USb-dB/5ns-Spike-Based-RRAM-Memory-Controller-/Documentnts_Reports/Presentation.pdf

# DE0-NANO

## The DE0-Nano board is a compact and versatile FPGA development platform designed by

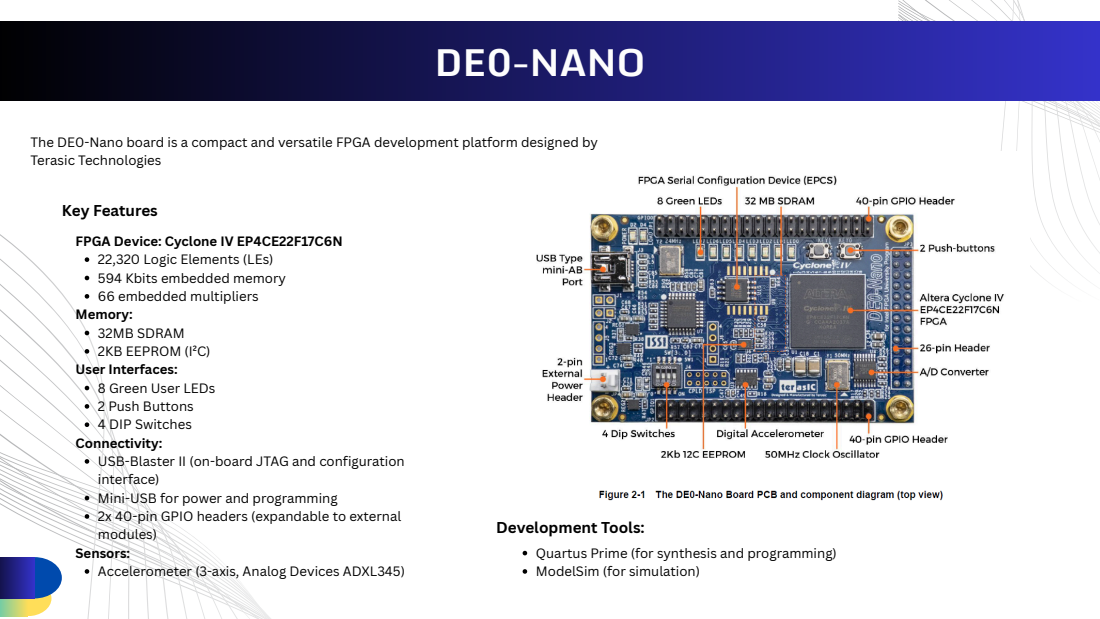
[picture p32: page 1]
Terasic Technologies; Key Features

FPGA Device: Cyclone IV EP4CE22F17C6N
22,320 Logic Elements (LEs)
594 Kbits embedded memory
66 embedded multipliers
Memory:
32MB SDRAM
2KB EEPROM (I²C)
User Interfaces:
8 Green User LEDs
2 Push Buttons
4 DIP Switches
Connectivity:
USB-Blaster II (on-board JTAG and configuration
interface)
Mini-USB for power and programming
2x 40-pin GPIO headers (expandable to external
modules)
Sensors:
Accelerometer (3-axis, Analog Devices ADXL345)

Development Tools:
Quartus Prime (for synthesis and programming)
ModelSim (for simulation)

# IN-BUILT CLOCK AND ADC

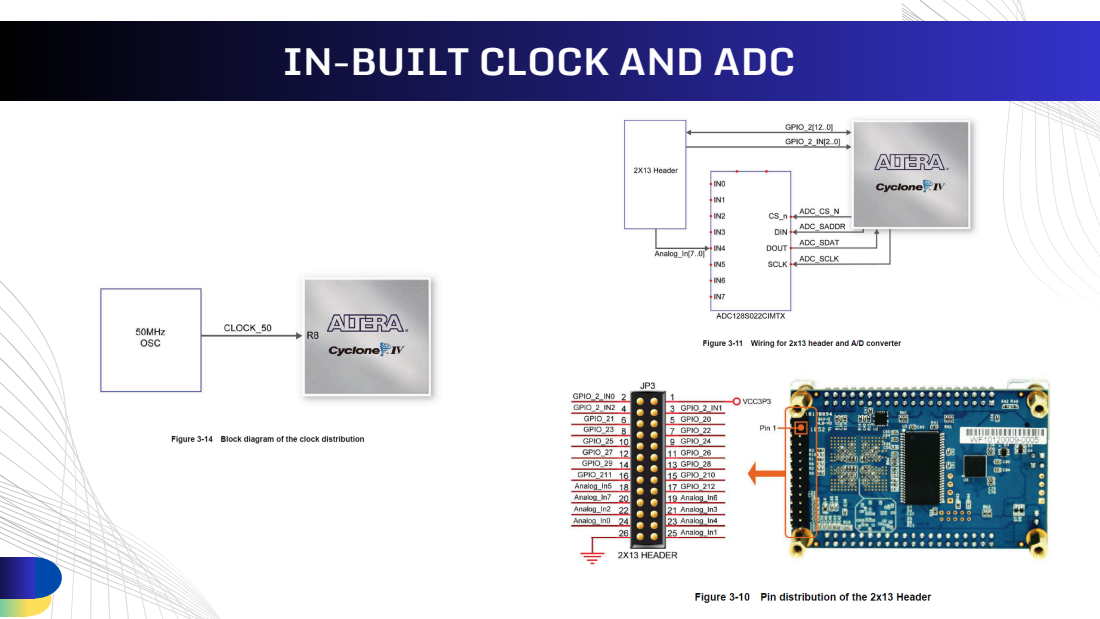
[picture p33: page 2]

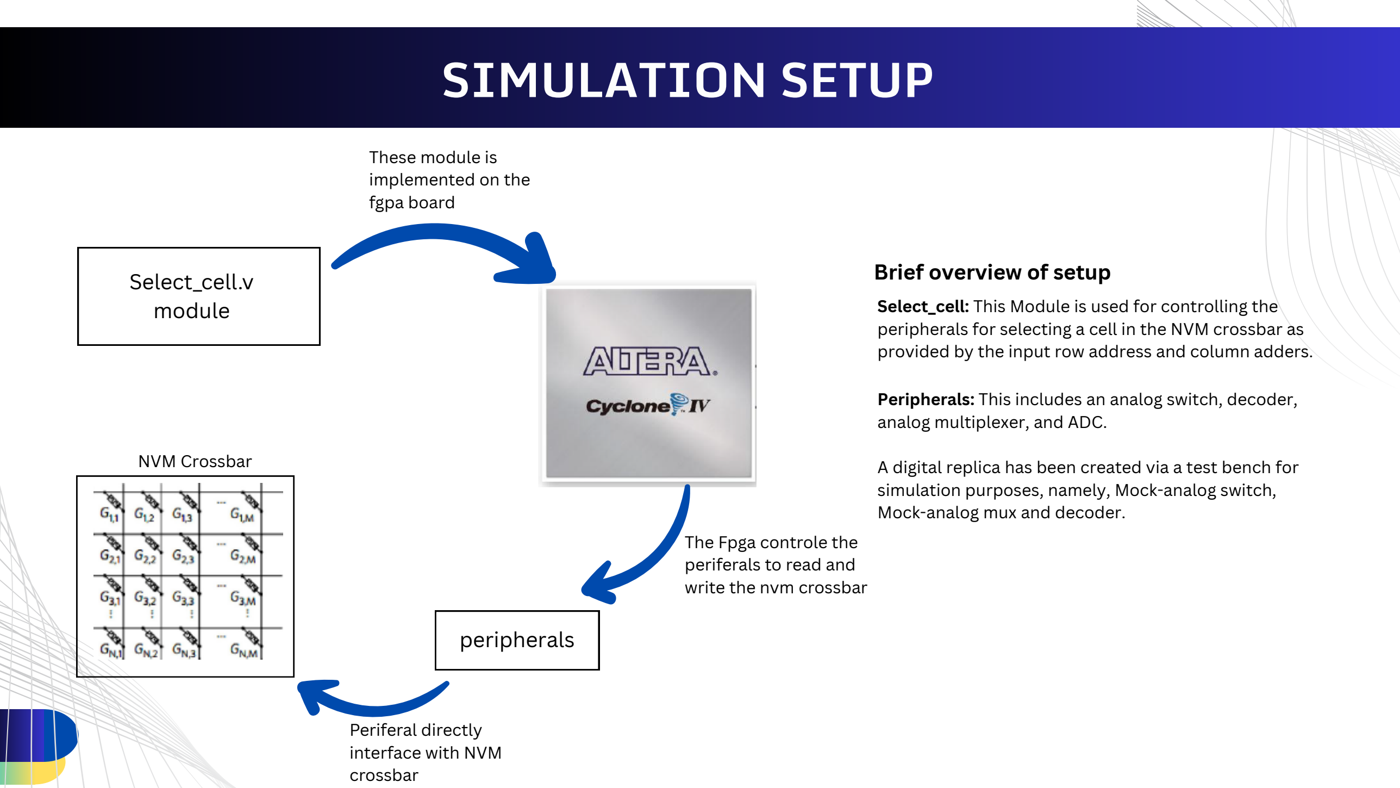
[picture p34: figure]
peripherals; SIMULATION SETUP; Select_cell.v module; These module is implemented on the fgpa board; The Fpga controle the periferals to read and write the nvm crossbar; Periferal directly interface with NVM crossbar; NVM Crossbar; analog multiplexer, and ADC.; Mock-analog mux and decoder.; Brief overview of setup

## Select_cell: This Module is used for controlling the peripherals for selecting a cell in the NVM crossbar as

provided by the input row address and column adders.

Peripherals: This includes an analog switch, decoder,

## A digital replica has been created via a test bench for

simulation purposes, namely, Mock-analog switch,

# SIMULATION SETUP

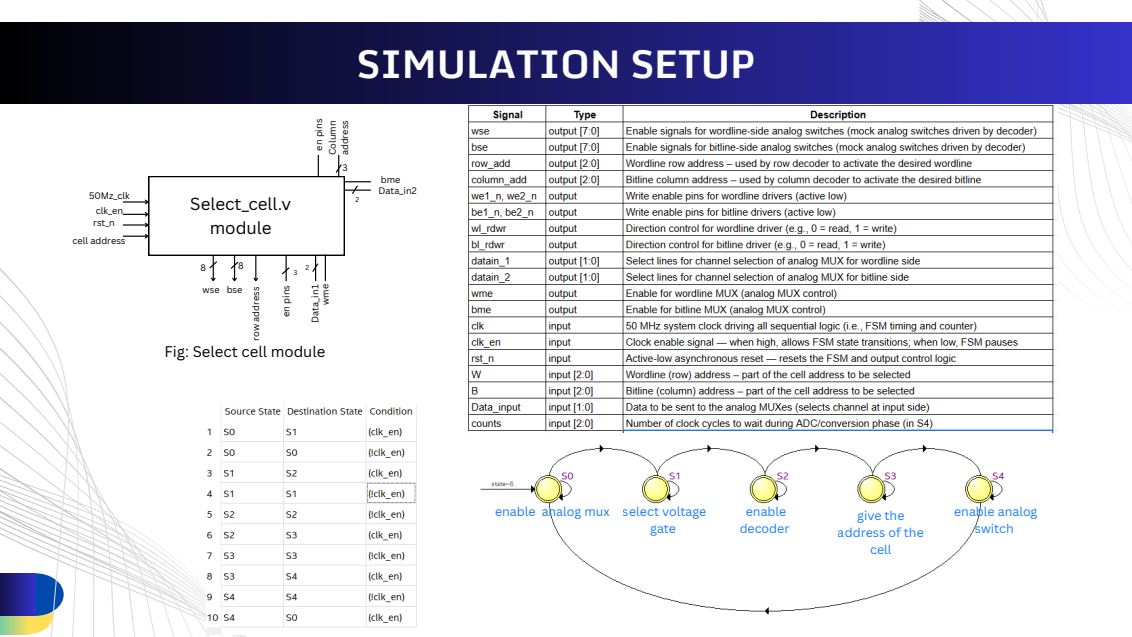
[picture p35: page 4]
pin; Select_cell.v module; 50Mz_clk clk_en rst_n; cell address; bme Data_in2; olu; dre; ata; wse bse; gate; enable decoder; enable analog switch

Fig: Select cell module

enable analog mux select voltage

give the
address of the
cell

# SIMULATION SETUP

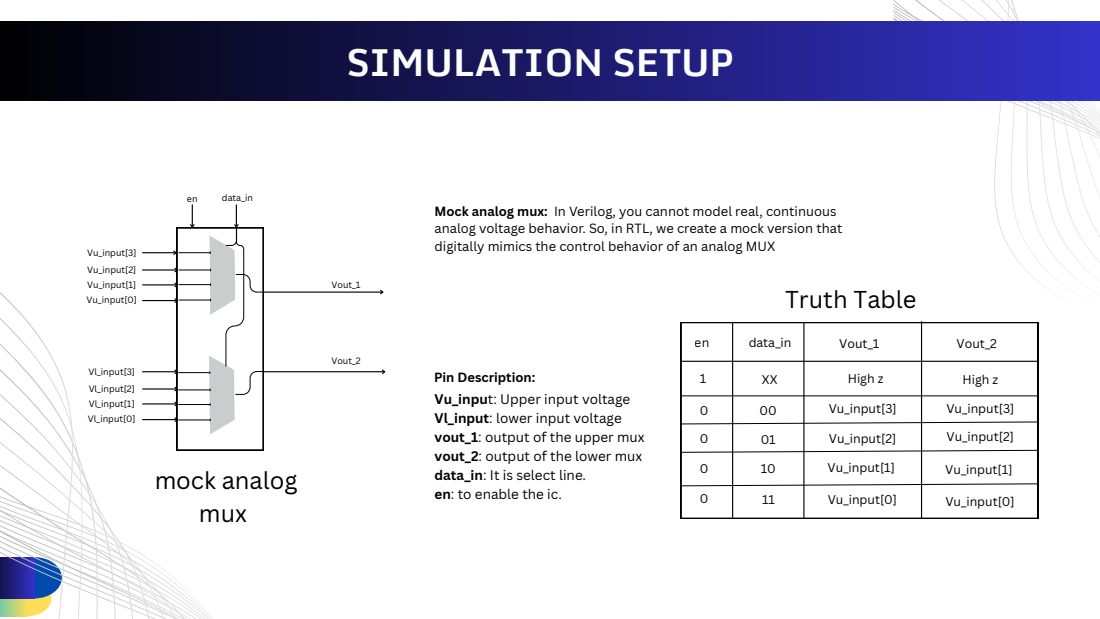
[picture p36: page 5]
mock analog mux; Vout_1; Vout_2; data_in; Vu_input[3]; Vu_input[2] Vu_input[1] Vu_input[0]; Vl_input[3]; Vl_input[2] Vl_input[1] Vl_input[0]; Vu_input[2]; Vu_input[1]; Vu_input[0]; Truth Table; High z

Mock analog mux: In Verilog, you cannot model real, continuous
analog voltage behavior. So, in RTL, we create a mock version that
digitally mimics the control behavior of an analog MUX

Pin Description:
Vu_input: Upper input voltage
Vl_input: lower input voltage
vout_1: output of the upper mux
vout_2: output of the lower mux
data_in: It is select line.
en: to enable the ic.

# SIMULATION SETUP

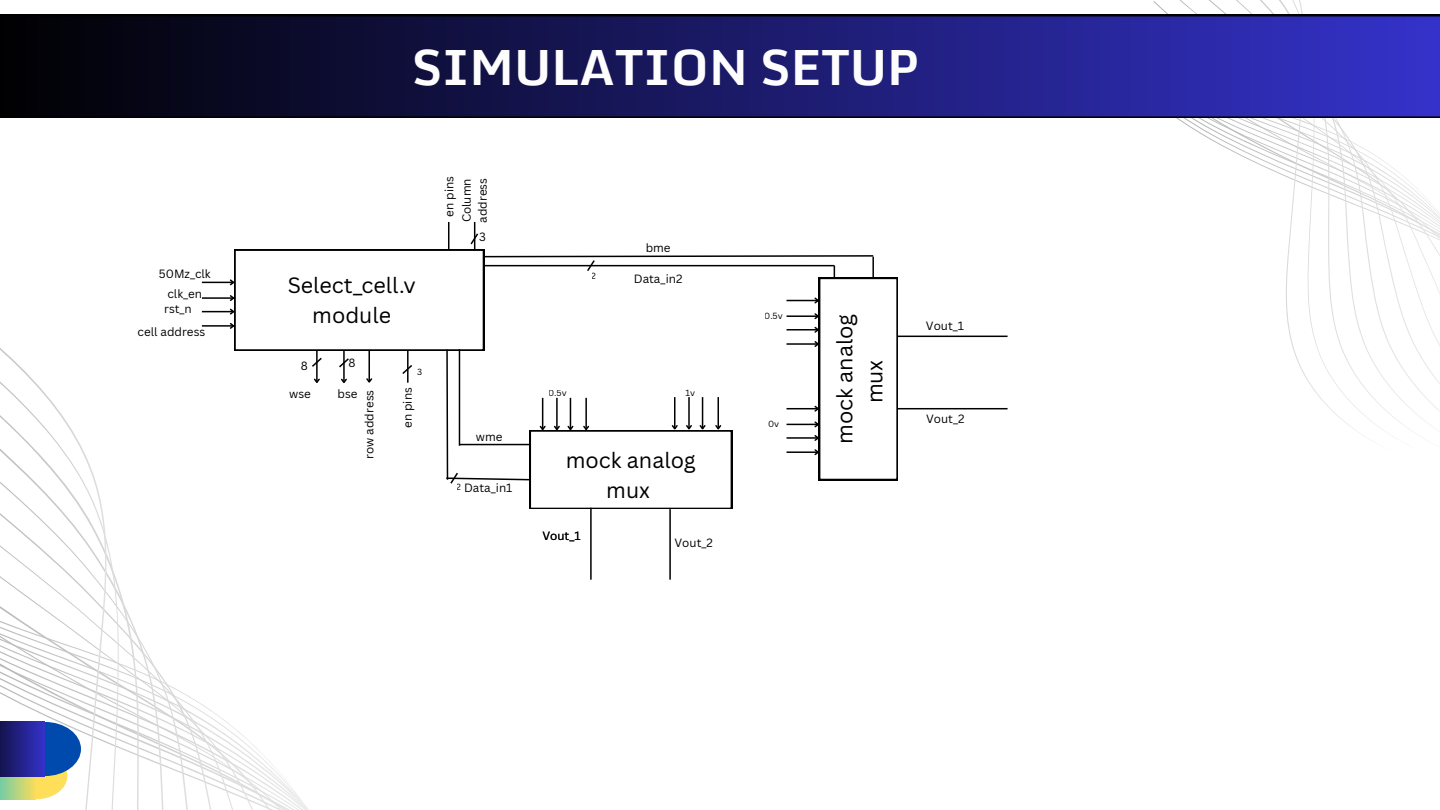
[picture p37: page 6]
Select_cell.v module; mock analog mux; alo; bme; Data_in2; Vout_1; 50Mz_clk clk_en rst_n; cell address; wse; bse; wme; Data_in1; pin; olu; dre; Vout_2

# SIMULATION SETUP

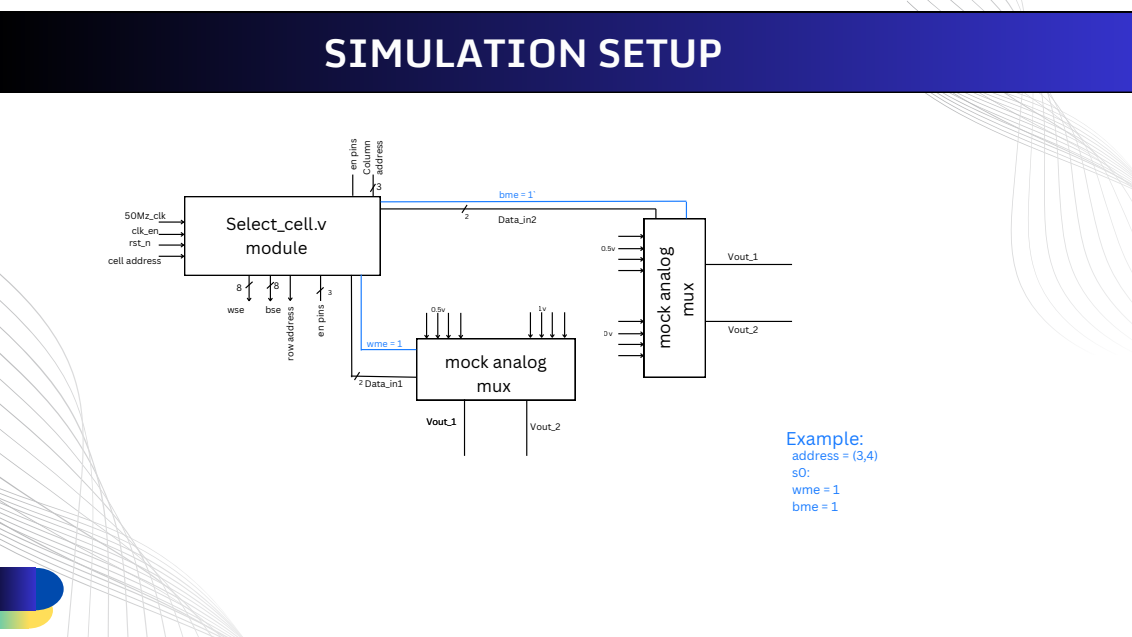
[picture p38: page 7]
Select_cell.v module; mock analog mux; alo; bme = 1`; Data_in2; Vout_1; 50Mz_clk clk_en rst_n; cell address; wse; bse; wme = 1; Data_in1; pin; olu; dre; Vout_2; Example: address = (3,4) s0: wme = 1 bme = 1

# SIMULATION SETUP

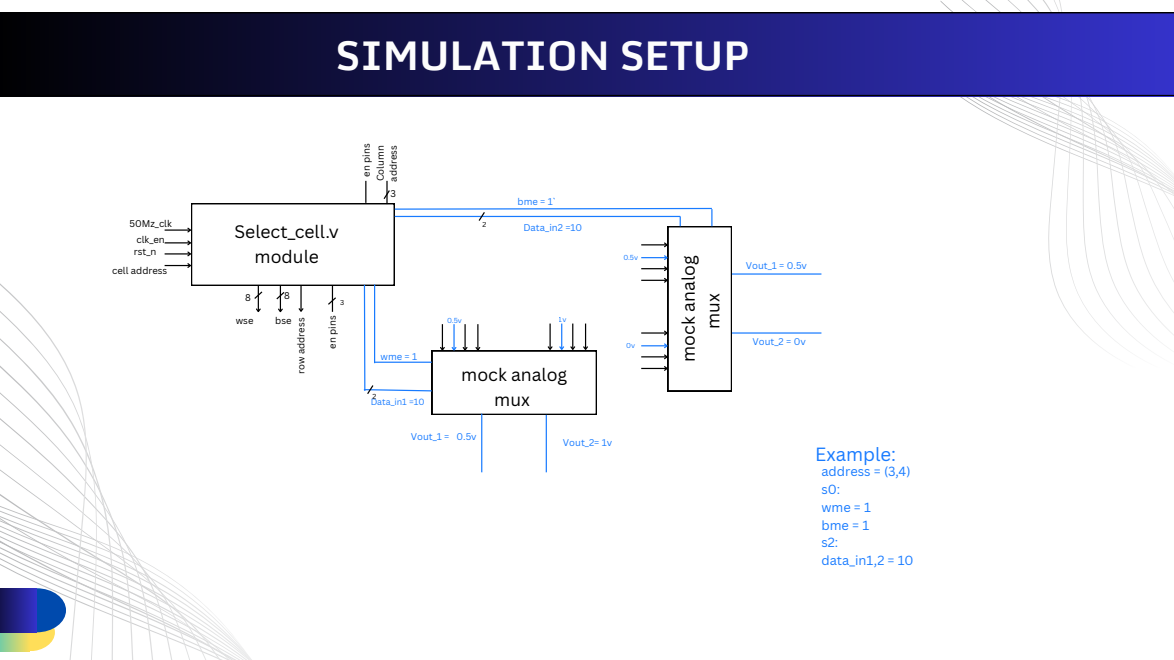
[picture p39: page 8]
Select_cell.v module; mock analog mux; alo; bme = 1`; Data_in2 =10; 50Mz_clk; clk_en rst_n; cell address; wse; bse; wme = 1; Data_in1 =10 ²; pin; olu; dre; Vout_1 = 0.5v; Vout_2 = 0v; Vout_2= 1v; Example: address = (3,4) s0: wme = 1 bme = 1 s2: data_in1,2 = 10

# SIMULATION SETUP

# 3:8 column

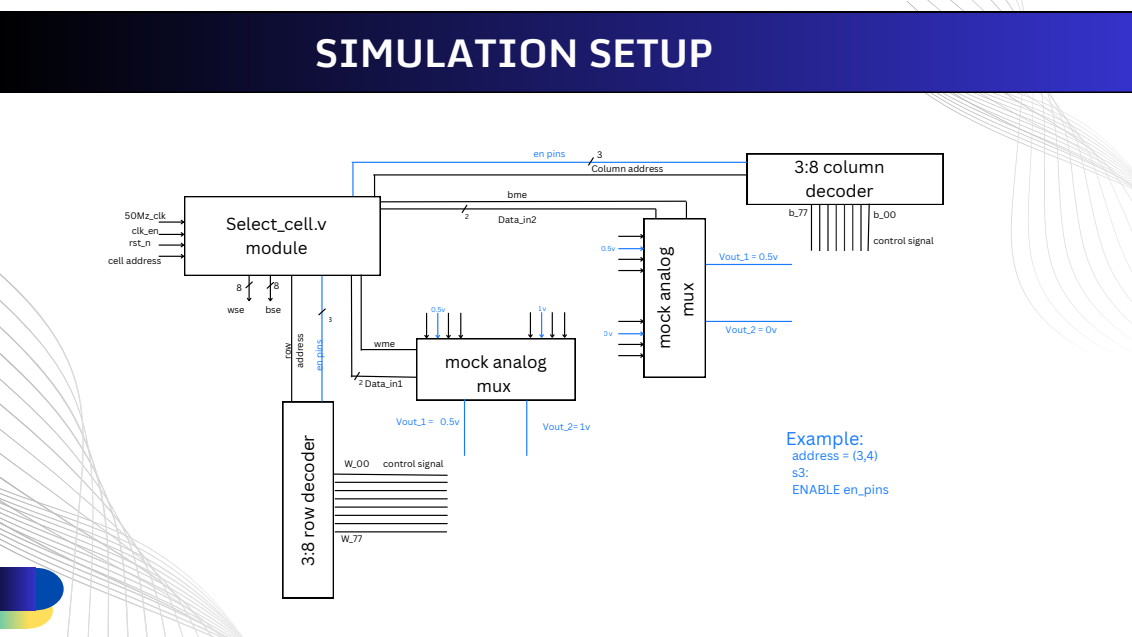
[picture p40: page 9]
Select_cell.v module; decoder; mock analog mux; alo; bme; Data_in2; en pins; Column address; dre; pin; control signal; 50Mz_clk clk_en rst_n; cell address; wse; bse; wme; Data_in1; Vout_1 = 0.5v; Vout_2 = 0v; Vout_2= 1v; Example: address = (3,4) s3: ENABLE en_pins

# SIMULATION SETUP

# 3:8 column

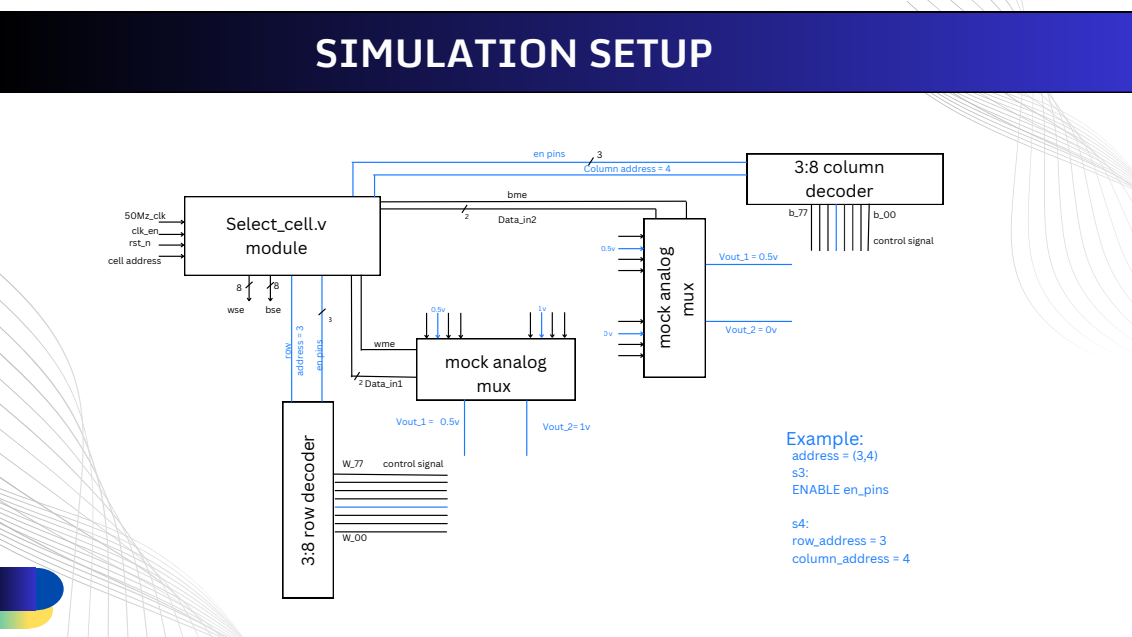
[picture p41: page 10]
Select_cell.v module; decoder; mock analog mux; alo; bme; Data_in2; en pins; Column address = 4; dre; pin; control signal; 50Mz_clk clk_en rst_n; cell address; wse; bse; wme; Data_in1; Vout_1 = 0.5v; Vout_2 = 0v; Vout_2= 1v; Example: address = (3,4) s3: ENABLE en_pins; s4: row_address = 3 column_address = 4

# SIMULATION SETUP

Vin_1 | Vin_2

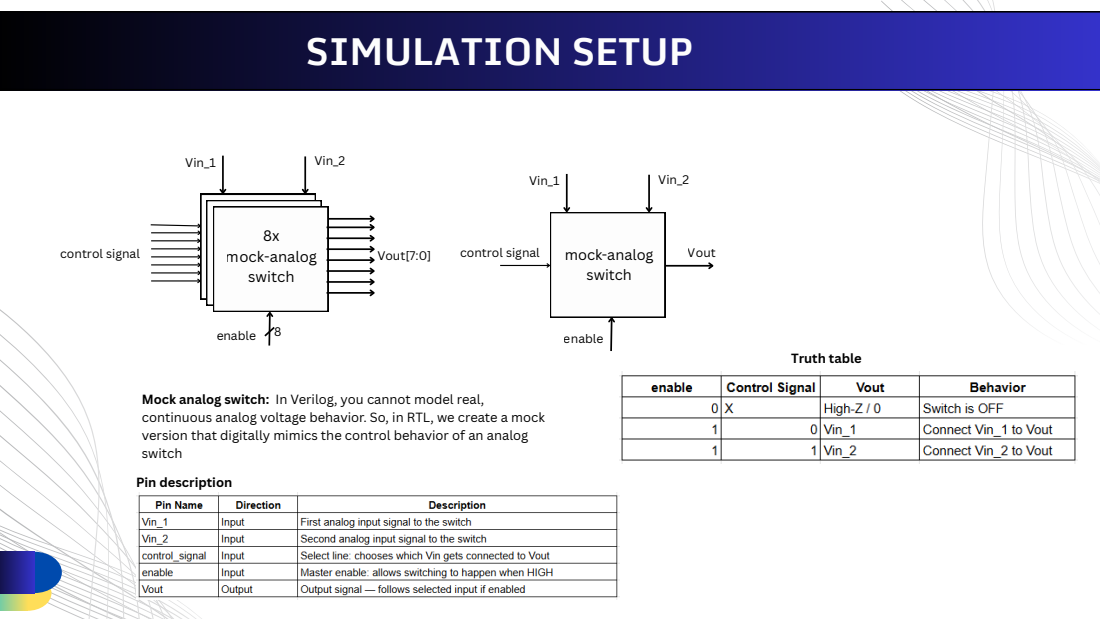
[picture p42: page 11]
enable; 8x mock-analog switch; control signal; mock-analog switch; Vin_1; Vin_2; Vout[7:0]; Vout; Truth table

Mock analog switch: In Verilog, you cannot model real,
continuous analog voltage behavior. So, in RTL, we create a mock
version that digitally mimics the control behavior of an analog
switch
Pin description

# SIMULATION SETUP

# 3:8 column

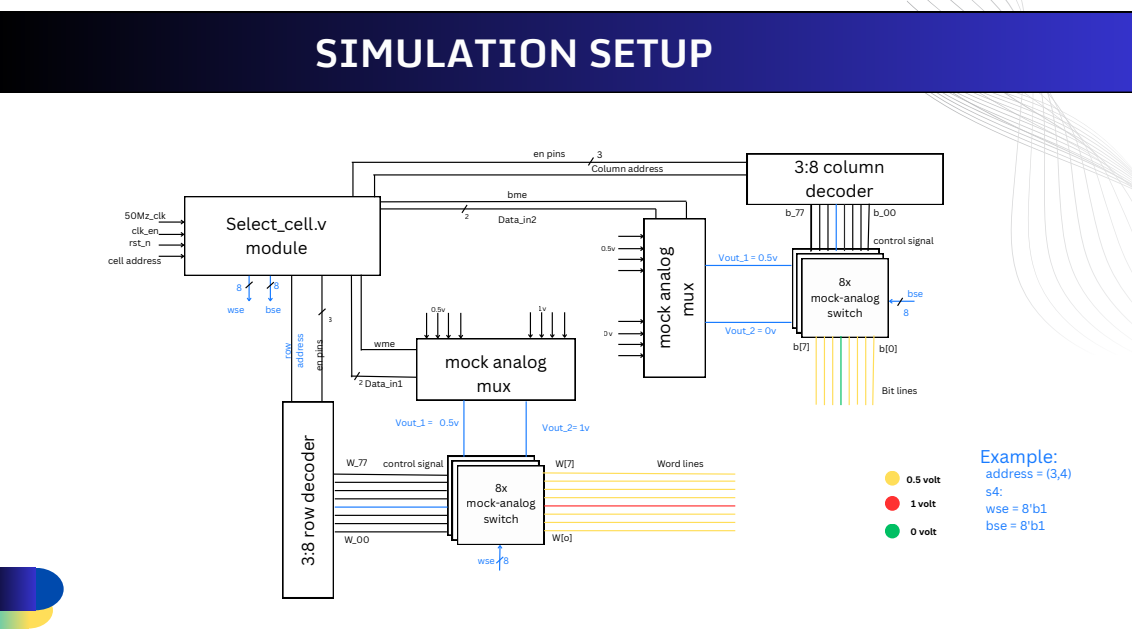
[picture p43: page 12]
Select_cell.v module; 8x mock-analog switch; decoder; mock analog mux; alo; bme; Data_in2; en pins; Column address; dre; pin; control signal; Bit lines; Word lines; 50Mz_clk clk_en rst_n; cell address; wse; bse; wme; Data_in1; Vout_1 = 0.5v; Vout_2 = 0v; Vout_2= 1v; 0.5 volt; 1 volt; 0 volt; Example: address = (3,4) s4: wse = 8'b1 bse = 8'b1

# SIMULATION SETUP

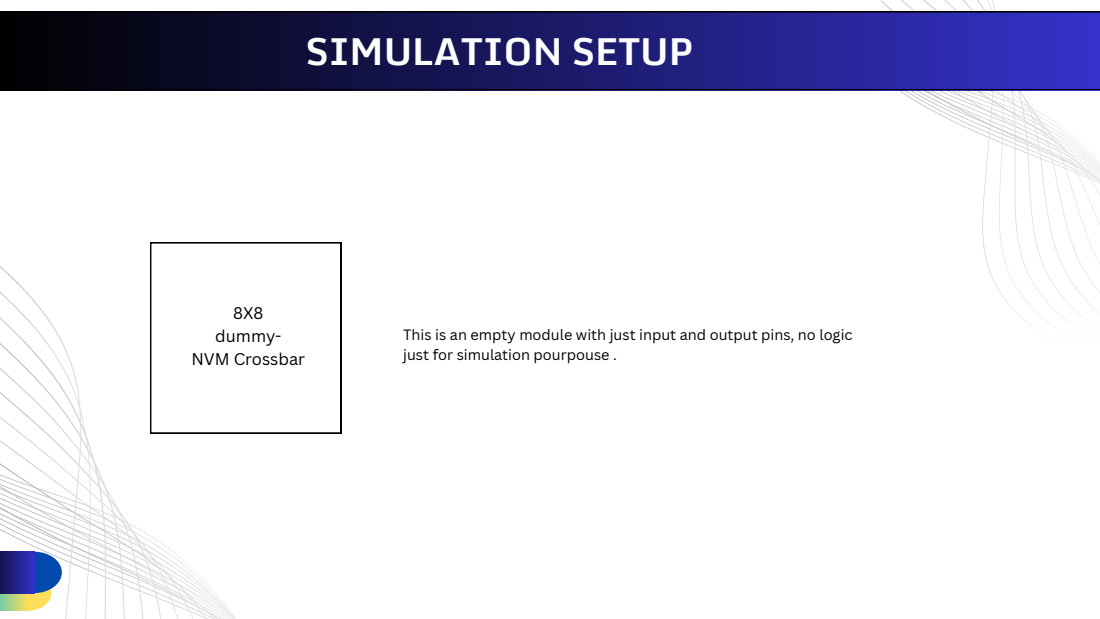
[picture p44: page 13]
8X8 dummy- NVM Crossbar

This is an empty module with just input and output pins, no logic
just for simulation pourpouse .

# SIMULATION SETUP

# 3:8 column

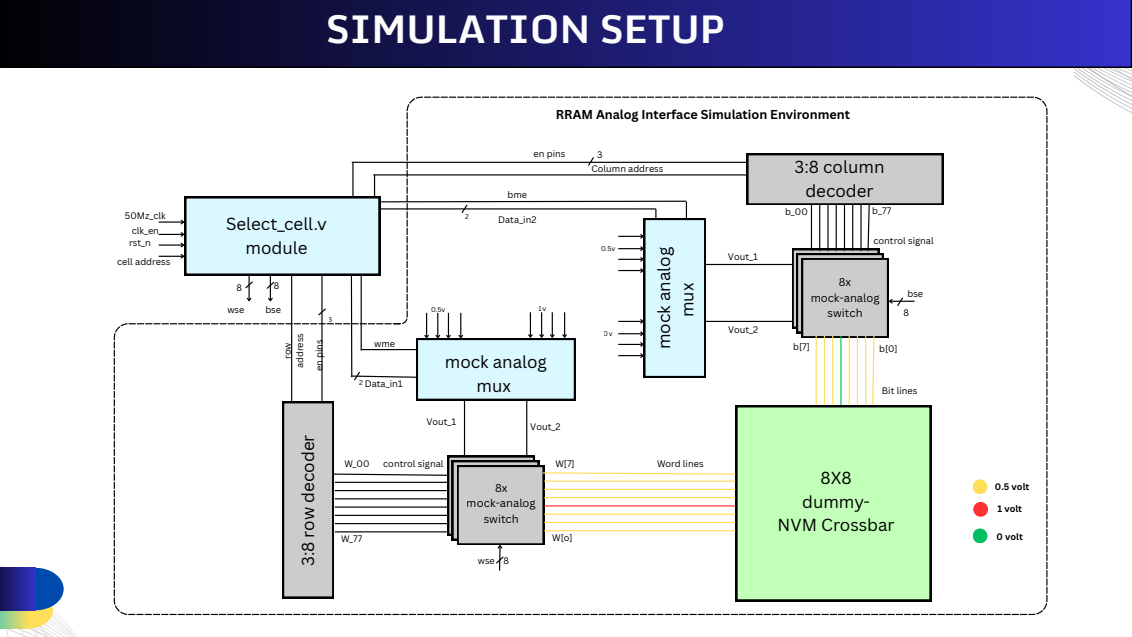
[picture p45: page 14]
8X8 dummy- NVM Crossbar; Select_cell.v module; 8x mock-analog switch; decoder; mock analog mux; alo; bme; Data_in2; en pins; Column address; dre; pin; control signal; Vout_1; Vout_2; 50Mz_clk clk_en rst_n; cell address; wse; bse; wme; Data_in1; Bit lines; Word lines; 0.5 volt; 1 volt; 0 volt

RRAM Analog Interface Simulation Environment

# RESULTS

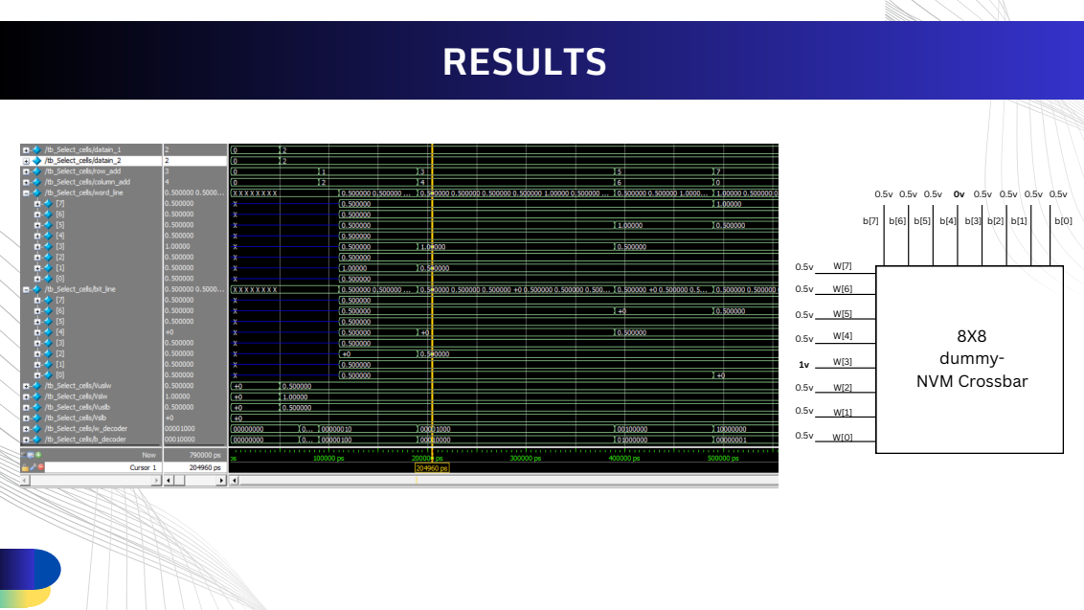
[picture p46: page 15]
8X8 dummy- NVM Crossbar

# NEW ADJUSTMENTS

State 5: Added a new state S5 in the FSM of select_cel, an idle state where it produces a signal “done” and remains in the state until the “Restart” signal is made high.
Done: an output signal from select_cell, which implies that the operation, i.e selecting the cell, is done, which can be later used and SOC ( start of conversion of ADC)
Restart: To return back to the S0 state for a new selecting operation.
Count : It's also an input to the Select_cell. It determines the pulse width of the select pulse, effectively turning the selection operation into a pulsing operation.

# EXPREMENT SETTINGS

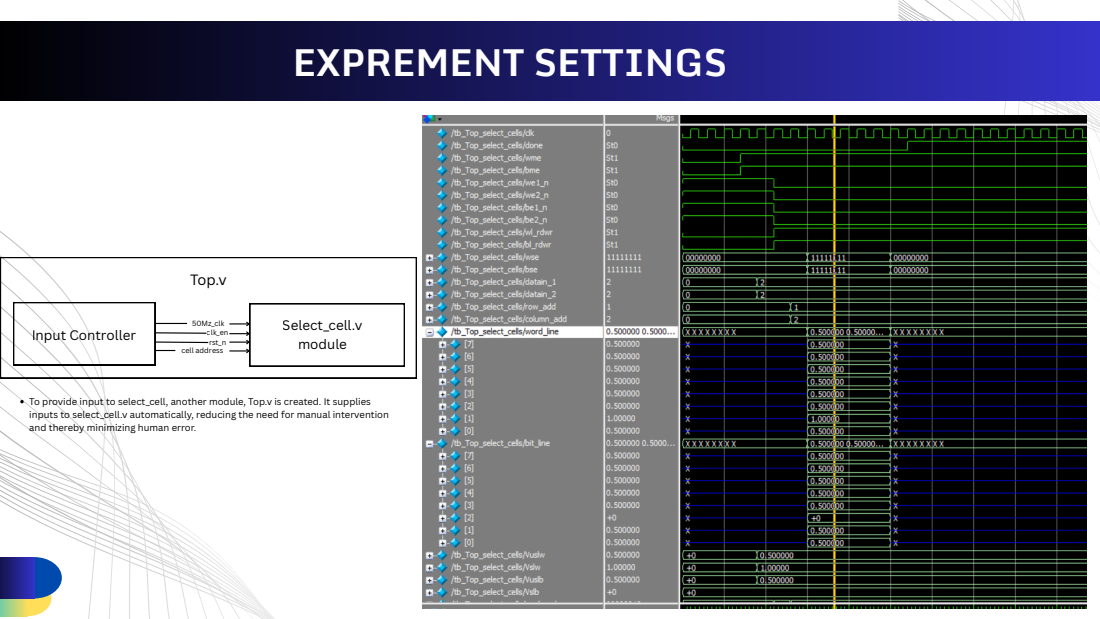
[picture p47: page 17]
clk_en rst_n; Select; cell.v module; 50Mz_clk; cell address; Input Controller; Top.v

To provide input to select_cell, another module, Top.v is created. It supplies
inputs to select_cell.v automatically, reducing the need for manual intervention
and thereby minimizing human error.

# SYNTHESIS DETAILS

Pin assignments were done before synthesis.

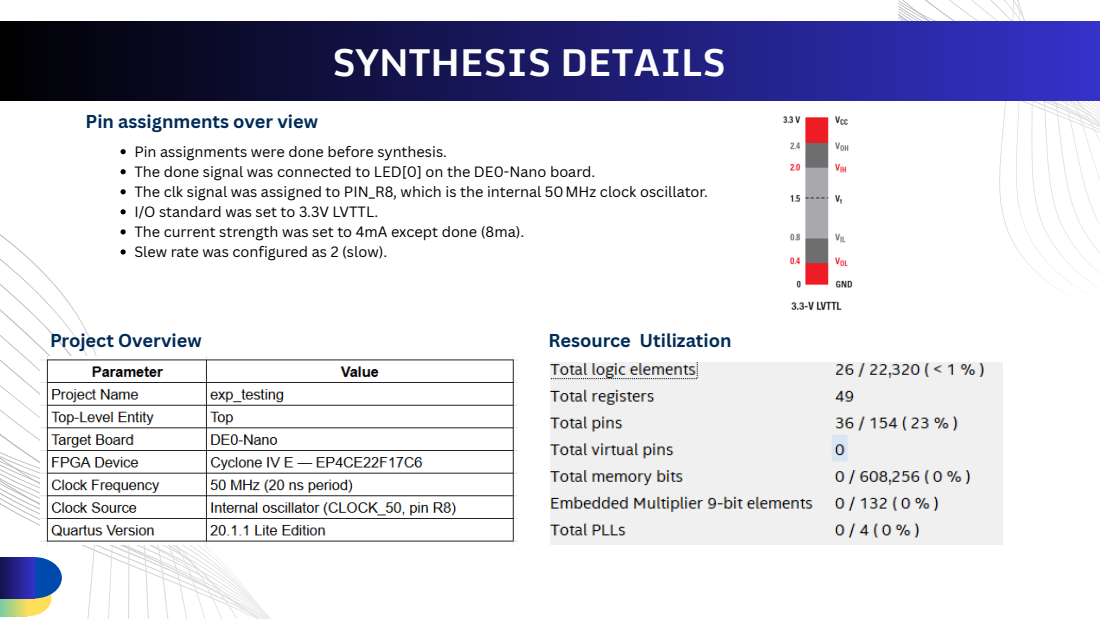
[picture p48: page 18]
Project Overview; Resource Utilization

Pin assignments over view

The done signal was connected to LED[0] on the DE0-Nano board.
The clk signal was assigned to PIN_R8, which is the internal 50MHz clock oscillator.
I/O standard was set to 3.3V LVTTL.
The current strength was set to 4mA except done (8ma).
Slew rate was configured as 2 (slow).

# TIMING ANALYSIS REPORT

# worst-case timing slacks

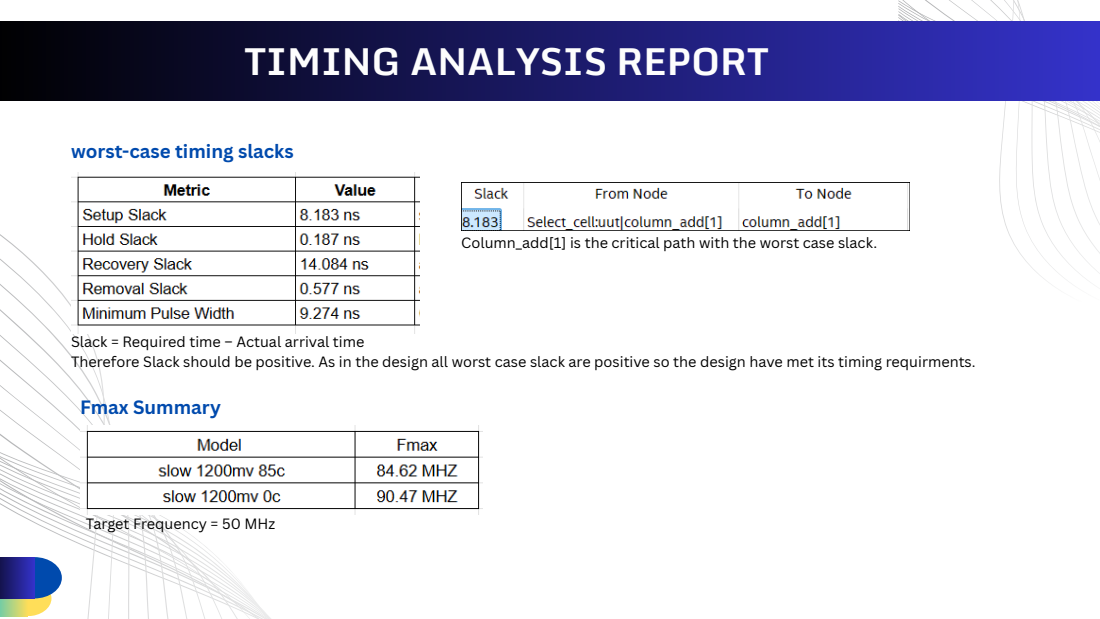
[picture p49: page 19]

Column_add[1] is the critical path with the worst case slack.

Slack = Required time – Actual arrival time
Therefore Slack should be positive. As in the design all worst case slack are positive so the design have met its timing requirments.
Fmax Summary

Target Frequency = 50 MHz

# PRECAUTIONS WHILE ON HARDWARE

# Human error while coding can cause wrong voltage

Solved by making the program hardcoded and tested in ModelSim.

# Logic level and driving current of FPGA should be set properly before

# programming

# Connect the hardware pins properly as per the pin assignments

# Verify pin connections multiple times

# Applied voltage should be set properly before applying to the hardware

It should not be more than 3.3V.

# For testing, we will use not more than 1V so it's safe

# Carefully connect the VCC and GND to the ICs

# NEXT

# Hardware Setup and Verification | Tentative time requirement: 1 to 2 days

1.Verify the hardware to ensure each component is functioning properly.
2.Implement the code and verify its functionality by checking the wordline and bitline voltages using an oscilloscope or multimeter.

# Modify for Partial Bias Scheme (Read/Write) | Tentative time requirement: 3 days

Modify the code for reading and writing each cell at a time in nvm crossbar.

# Implement weight mapping and MAC operation | Tentative time requirement: 7 days

1.Modify the code to map weight in the NVM crossbar.
2.Implement Multiply multiply-accumulate operation in NvM crossbar using random weight.

# READ/WRITE PULSE

IN the expreiment the reada/write pulse was simulated for only 100 ns .

# We demonstrate that the model can reproduce experimentally observed Set and Reset transient across a range of timescale (100 ns – 1 s)

V. Saraswat et al., “Reaction-Drift Model for Switching Transients in Pr₀.₇Ca₀.₃MnO₃-Based Resistive RAM,” arXiv preprint arXiv:2005.07398, 2020. [Online]. Available: https://arxiv.org/abs/2005.07398
V. Saraswat et al.

# Why do we need a short voltage pulse?

Ensures precise switching without overdriving the cell. Reduces Joule heating and prevents thermal damage. Limits the sneak path current duration in crossbar arrays. Improves endurance by minimizing stress per cycle. Enables faster write and erase operations.
Prevents unintentional switching in nearby cells.
Lowers overall energy consumption during switching.

# Disasvantage!!!

## Due to delays of various ICs, how can we drive a precise 100 ns pulse at high frequency, like 50 MHz? How can the built-in ADC in the DE0-Nano sample the 100 ns read pulse?

# FREQUENCY CALCULATION

t

# _on(mux_en): Time required for the analog multiplexer to

become enabled.
t

# _on(sw

# _en): Time required for the analog switch to

become enabled.
t

_

trans1: Transition time of the analog multiplexer. t

_

trans2: Transition time of the analog switch.
t

_

# off(mux_en): Time required for the analog multiplexer to

disable after deasserting the enable signal.
t

_

# off(sw

# _en): Time required for the analog switch to disable

after deasserting the enable signal.

# t_p: propagation delay of decoder pw : pulse width of the read/write pulse

# Parameters

# Assumption

# t_p is neglected as it is very less compared to the other time parameters

# FREQUENCY CALCULATION

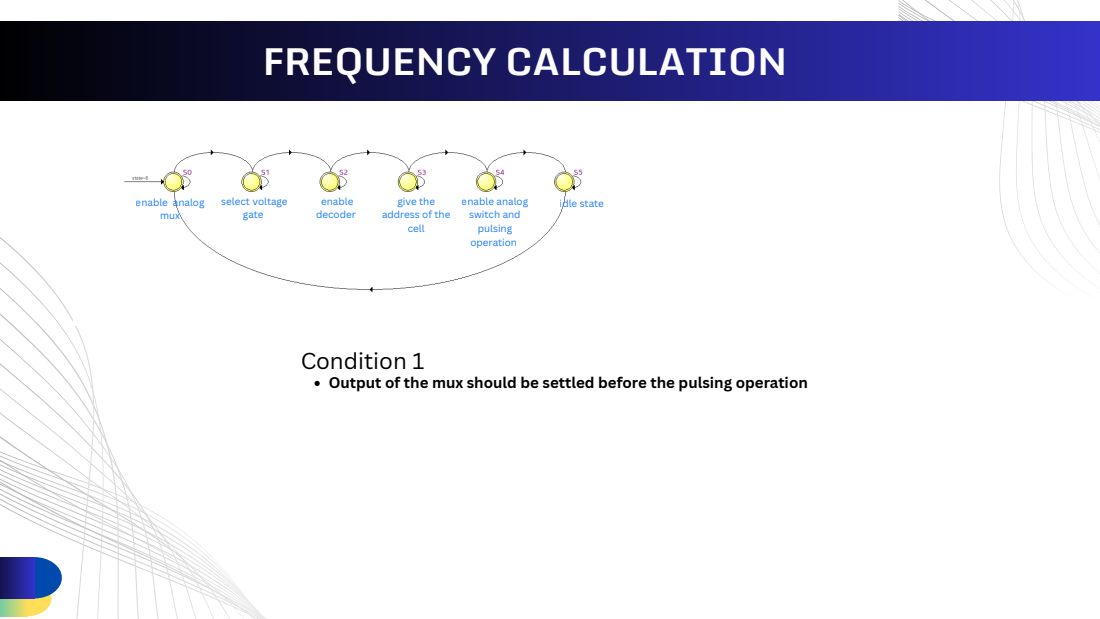
[picture p50: page 24]
enable analog mux; select voltage gate; enable decoder; enable analog switch and pulsing operation; idle state

give the
address of the
cell

Condition 1
Output of the mux should be settled before the pulsing operation

# FREQUENCY CALCULATION

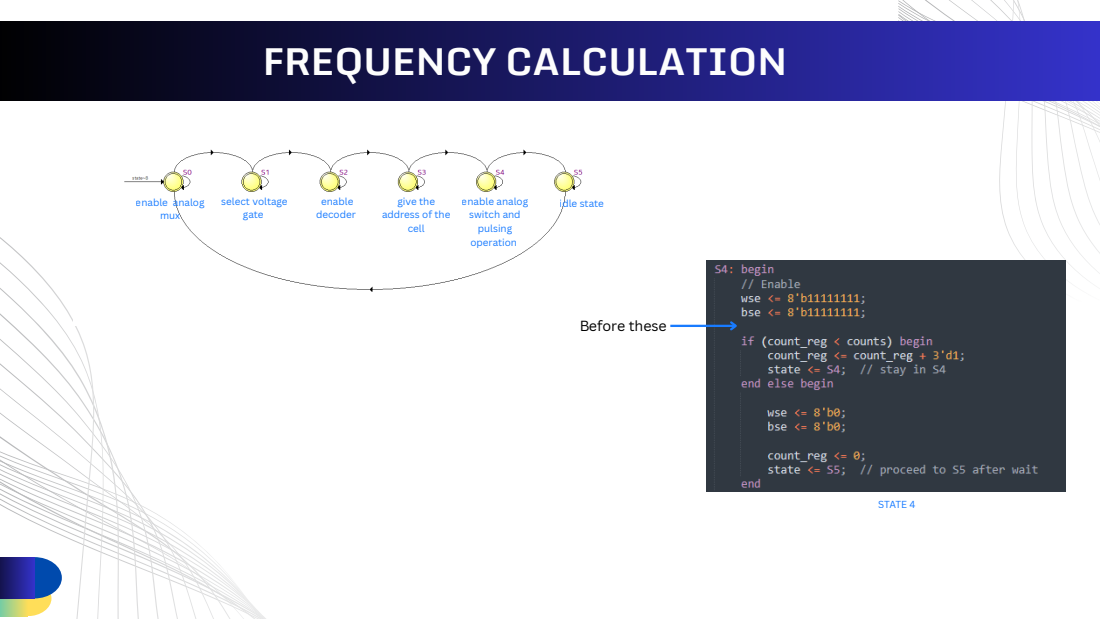
[picture p51: page 25]
enable analog mux; select voltage gate; enable decoder; enable analog switch and pulsing operation; idle state; STATE 4; Before these

give the
address of the
cell

# FREQUENCY CALCULATION

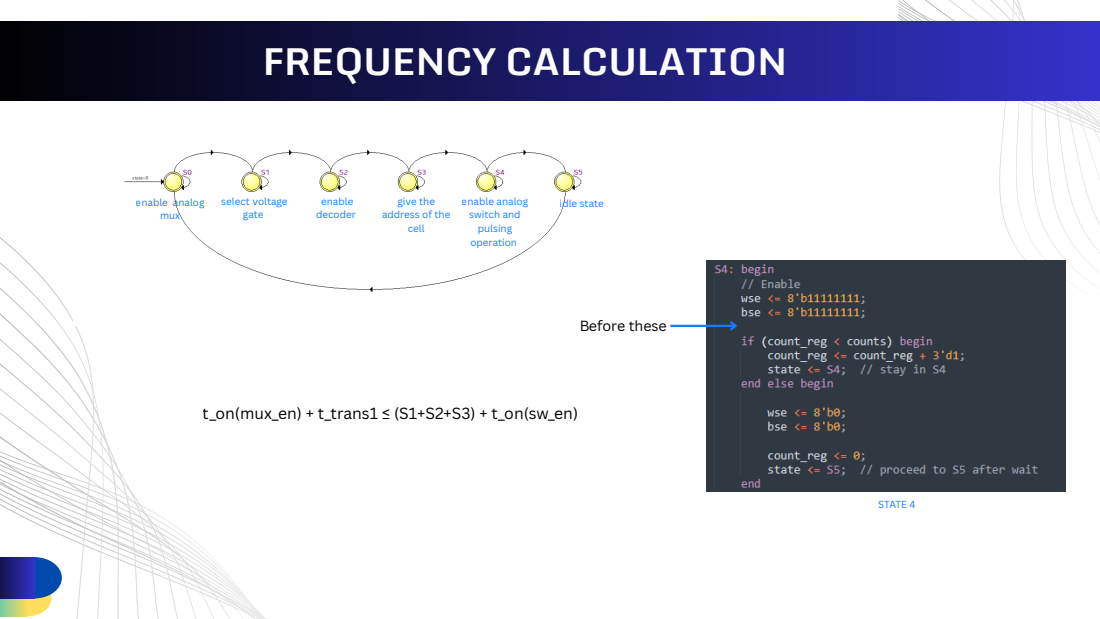
[picture p52: page 26]
enable analog mux; select voltage gate; enable decoder; enable analog switch and pulsing operation; idle state; STATE 4; Before these; on(mux; trans1 ≤ (S1+S2+S3) + t

give the
address of the
cell

# FREQUENCY CALCULATION

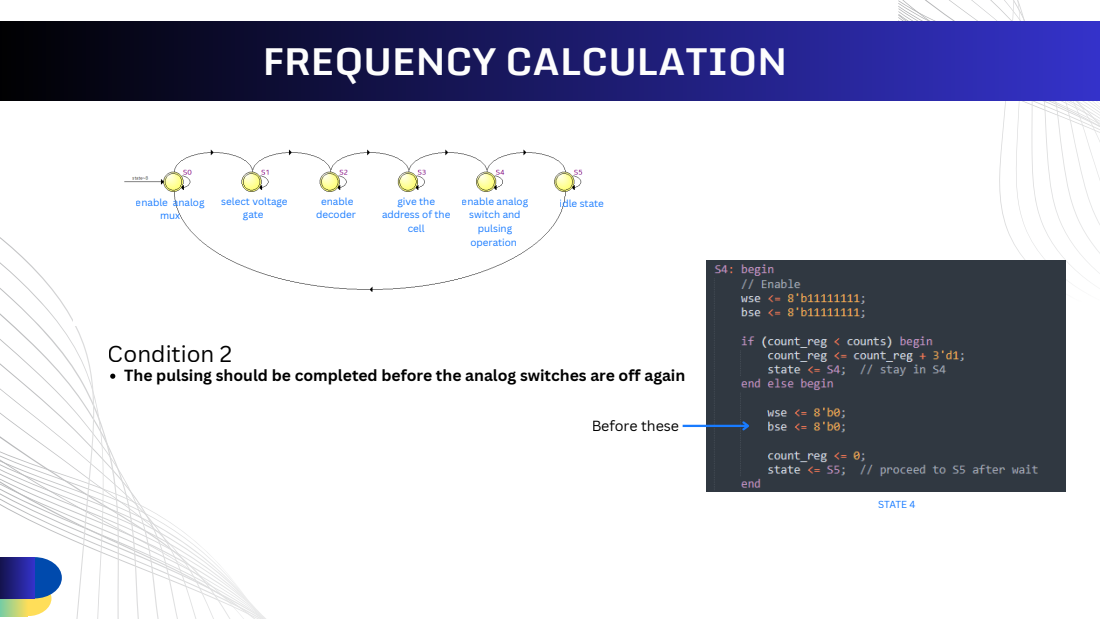
[picture p53: page 27]
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

give the
address of the
cell

Condition 2
The pulsing should be completed before the analog switches are off again

# FREQUENCY CALCULATION

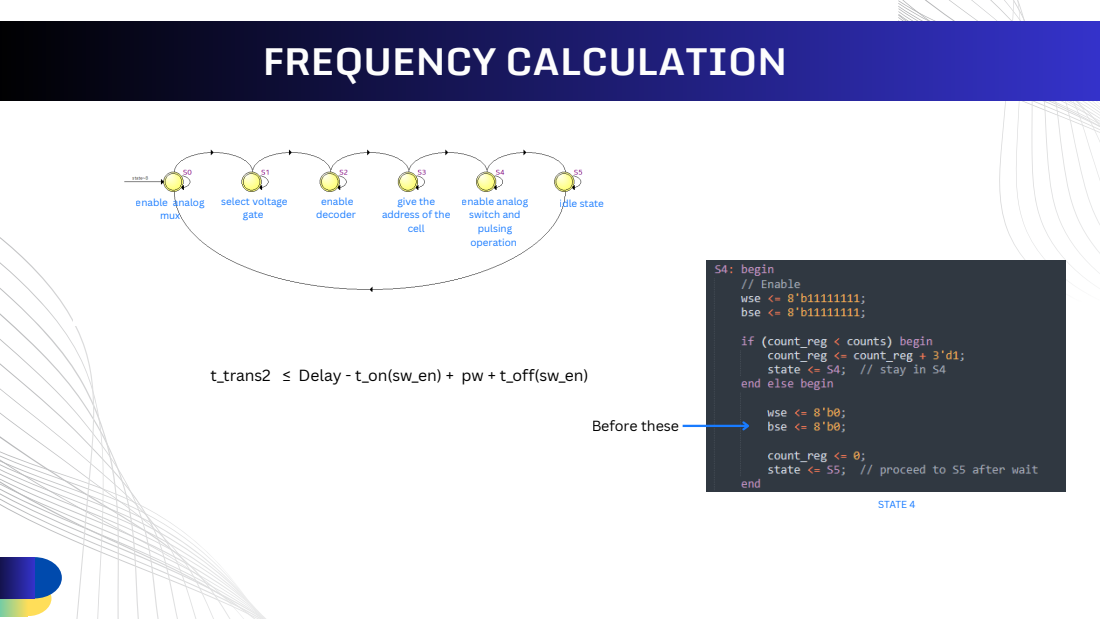
[picture p54: page 28]
enable analog mux; select voltage gate; enable decoder; enable analog switch and pulsing operation; idle state; STATE 4; t_trans2 ≤ Delay - t_on(sw_en) + pw + t_off(sw_en); Before these

give the
address of the
cell

# FREQUENCY CALCULATION

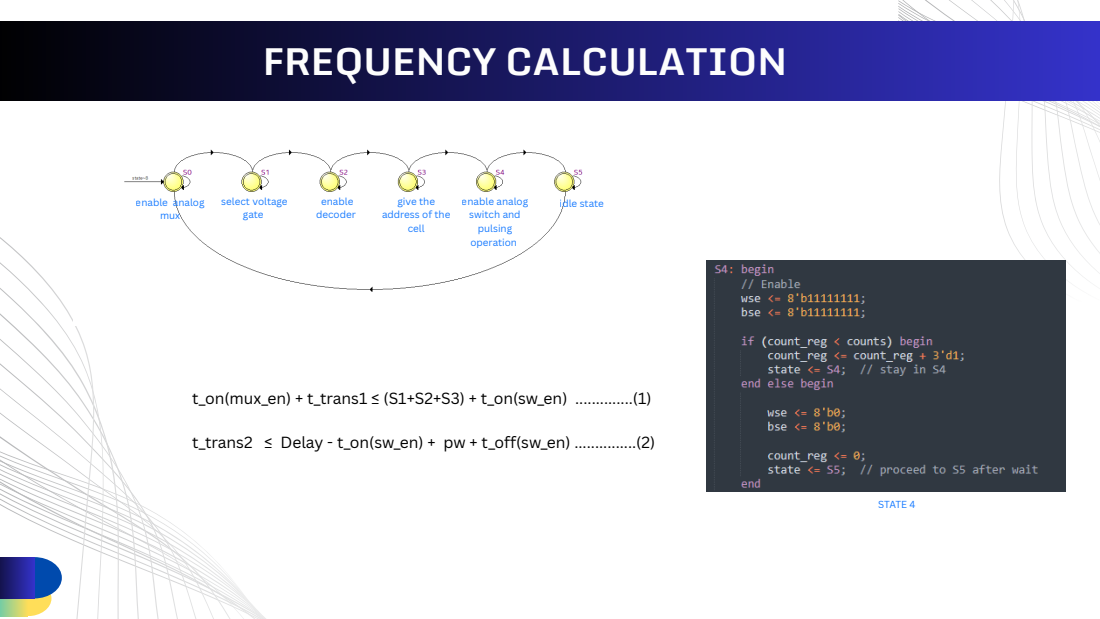
[picture p55: page 29]
enable analog mux; select voltage gate; enable decoder; enable analog switch and pulsing operation; idle state; STATE 4; t_trans2 ≤ Delay - t_on(sw_en) + pw + t_off(sw_en) ...............(2); t_on(mux_en) + t_trans1 ≤ (S1+S2+S3) + t_on(sw_en) ..............(1)

give the
address of the
cell

# FREQUENCY CALCULATION

# t_on(mux_en) + t_trans1 ≤ (S1+S2+S3) + t_on(sw_en) | (1)

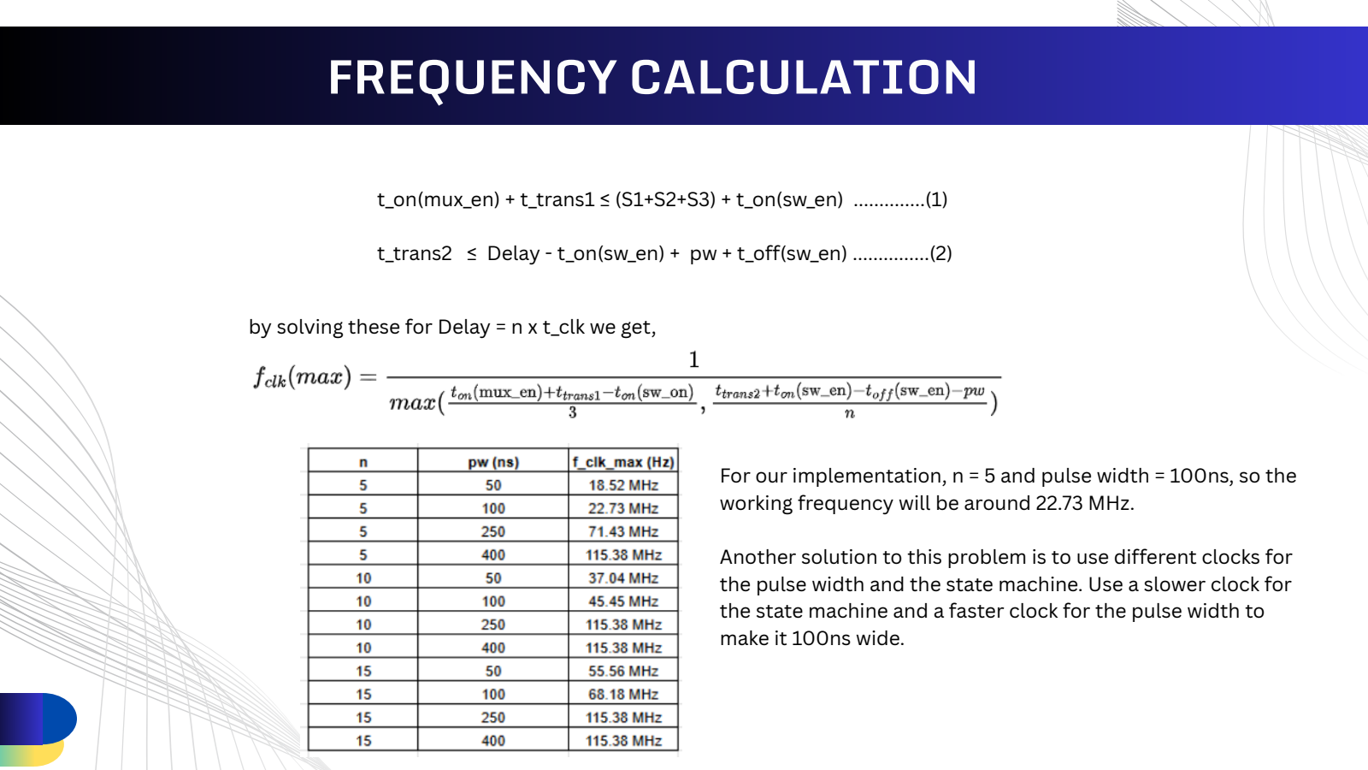
[picture p56: page 30]

# t_trans2 ≤ Delay - t_on(sw_en) + pw + t_off(sw_en) | (2)

by solving these for Delay = n x t_clk we get,

# For our implementation, n = 5 and pulse width = 100ns, so the

working frequency will be around 22.73 MHz.

# Another solution to this problem is to use different clocks for the pulse width and the state machine. Use a slower clock for the state machine and a faster clock for the pulse width to

make it 100ns wide.

# READ CIRCUITRY

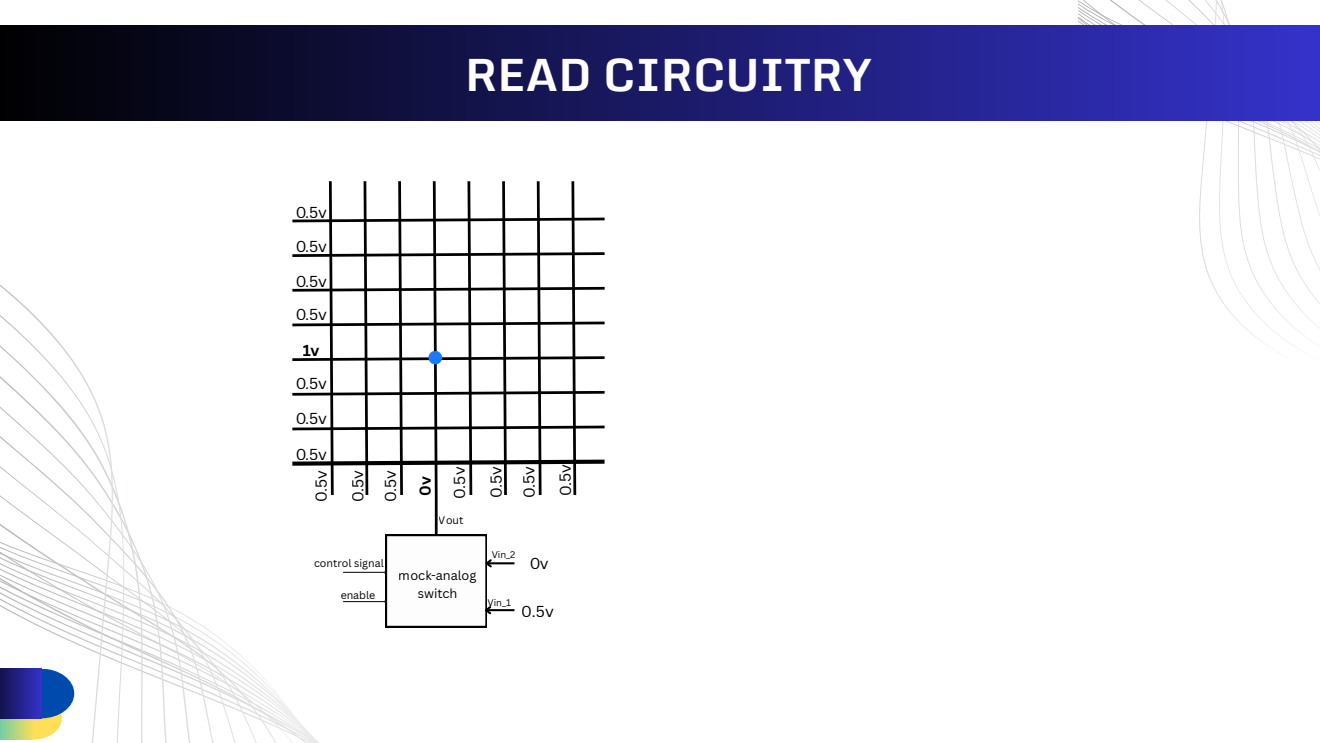
[picture p57: page 31]
mock-analog switch; Vin_1; Vin_2; enable; control signal; Vout

# READ CIRCUITRY

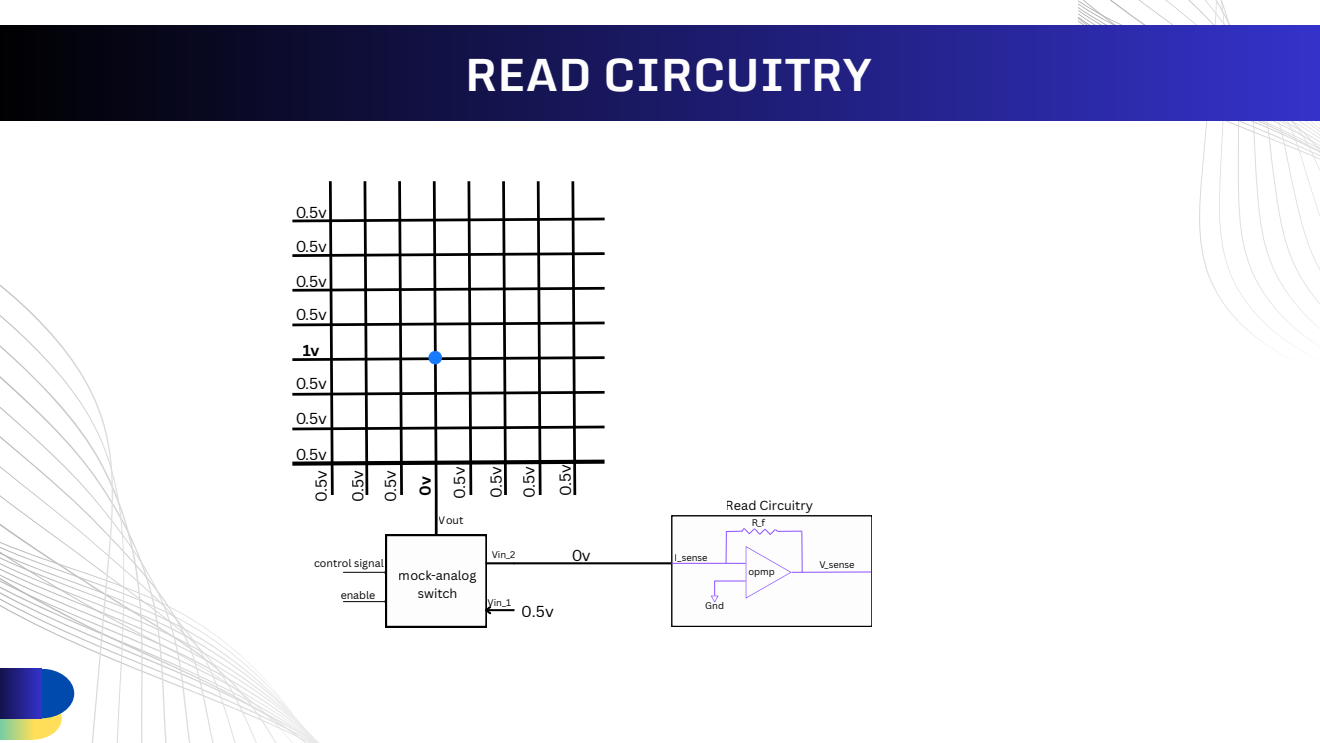
[picture p58: page 32]
mock-analog switch; Vin_1; Vin_2; enable; control signal; Vout; I_sense; V_sense; Gnd; opmp; Read Circuitry

# READ CIRCUITRY

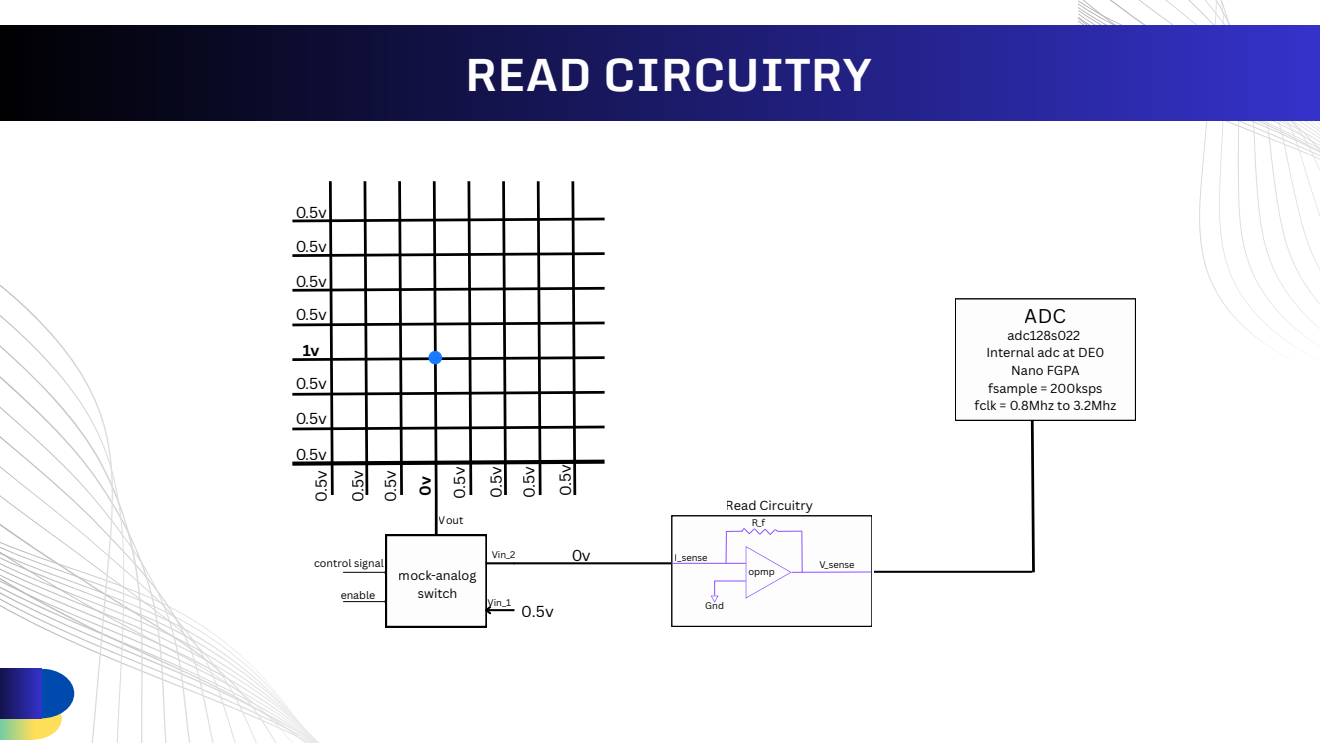
[picture p59: page 33]
mock-analog switch; Vin_1; Vin_2; enable; control signal; Vout; I_sense; V_sense; Gnd; opmp; Read Circuitry

ADC
adc128s022
Internal adc at DE0
Nano FGPA
fsample = 200ksps
fclk = 0.8Mhz to 3.2Mhz

# READ CIRCUITRY

ADC128S022 is an SPI-based analog-to-digital converter that completes one conversion in 16 clock cycles.

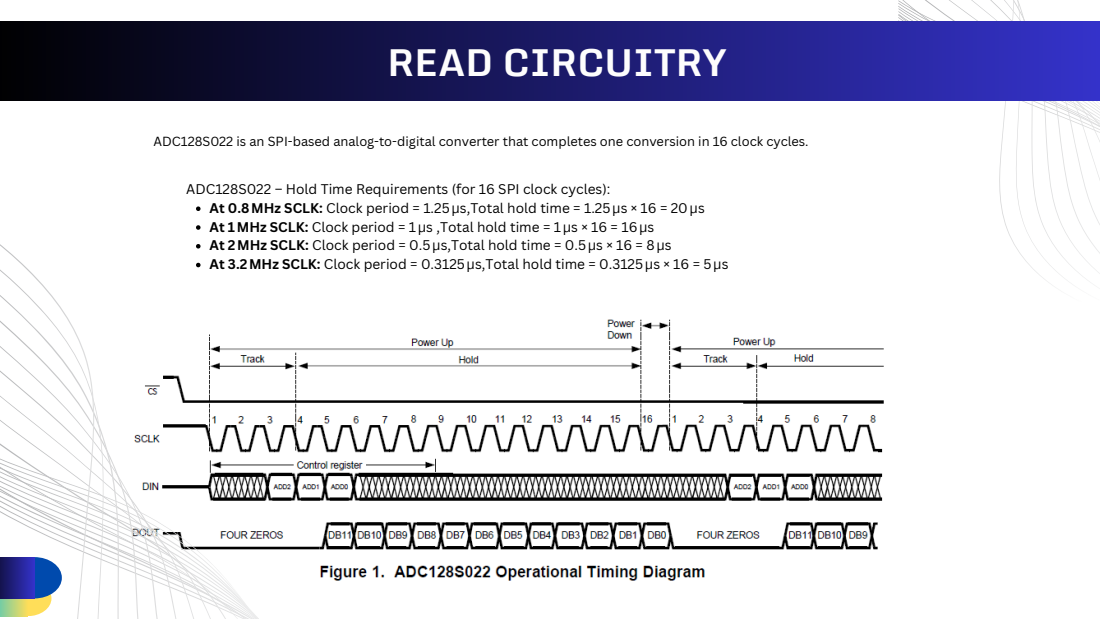
[picture p60: page 34]

ADC128S022 – Hold Time Requirements (for 16 SPI clock cycles):
At 0.8MHz SCLK: Clock period = 1.25µs,Total hold time = 1.25µs × 16 = 20µs
At 1MHz SCLK: Clock period = 1µs ,Total hold time = 1µs × 16 = 16µs
At 2MHz SCLK: Clock period = 0.5µs,Total hold time = 0.5µs × 16 = 8µs
At 3.2MHz SCLK: Clock period = 0.3125µs,Total hold time = 0.3125µs × 16 = 5µs

# READ CIRCUITRY

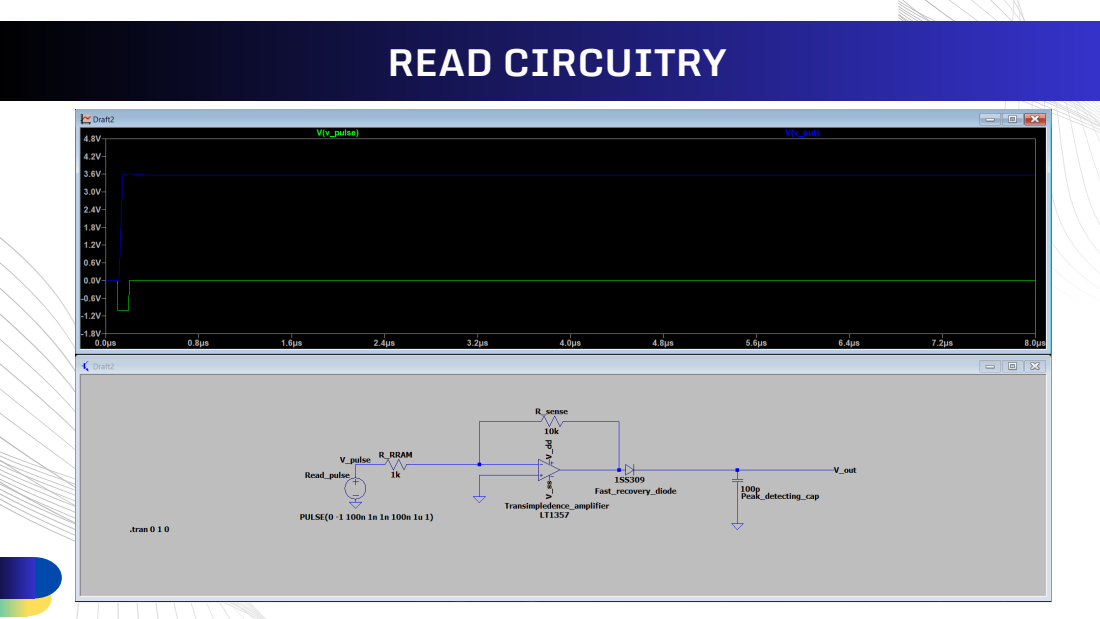
[picture p61: page 35]

# READ CIRCUITRY

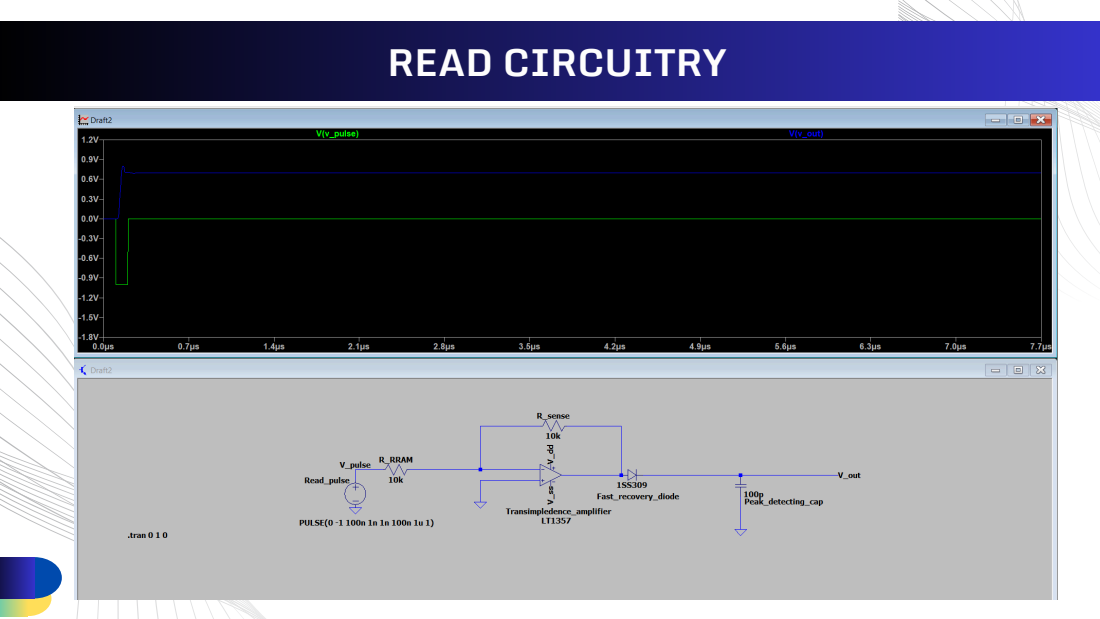
[picture p62: page 36]

if(iGO==1)

for count =
2,3,4

if(count==4)
if(count == 16)

### rst

# ADC CONTROL

count increments from 4
to 15 and data is stored
in increment of m_count
idle | start conversion

## send channel Bits

## sample ADC data end of converison

ACTIVE SAMPLING

## Pin Descriptions

## Inputs

iRST: Reset signal – active-low. Resets control logic and data registers.
iCLK: Main SPI clock – used for internal state timing and data shifting.
iCLK_n: Inverted SPI clock – used to align channel bit output and capture cont safely. iGO: Start Conversion – a pulse to initiate a new ADC conversion cycle.
iCH[2:0]: Channel Select – 3-bit input to select the ADC channel (0–7).
iDOUT: Serial Data from ADC – sampled bits from the ADC device (SDO).

## Outputs

oADC_data[11:0]: 12-bit Parallel Output – holds final ADC conversion result. oEOC: End of Conversion – high when conversion is complete and data is valid. oDIN: Serial Data to ADC – sends channel selection bits to ADC (SDI).
oCS_n: Chip Select (Active Low) – controls ADC access (driven low during active conversion).
oSCLK: SPI Clock Output – toggles with iCLK when conversion is active.

The count is an internal register that updates with every rising edge of the clock. The mcount is an internal register that updates with every falling edge of the clock. The channel bits are transmitted with each positive edge of sclk.
The adc sample bit is received at each negative edge of sclk.

O

B

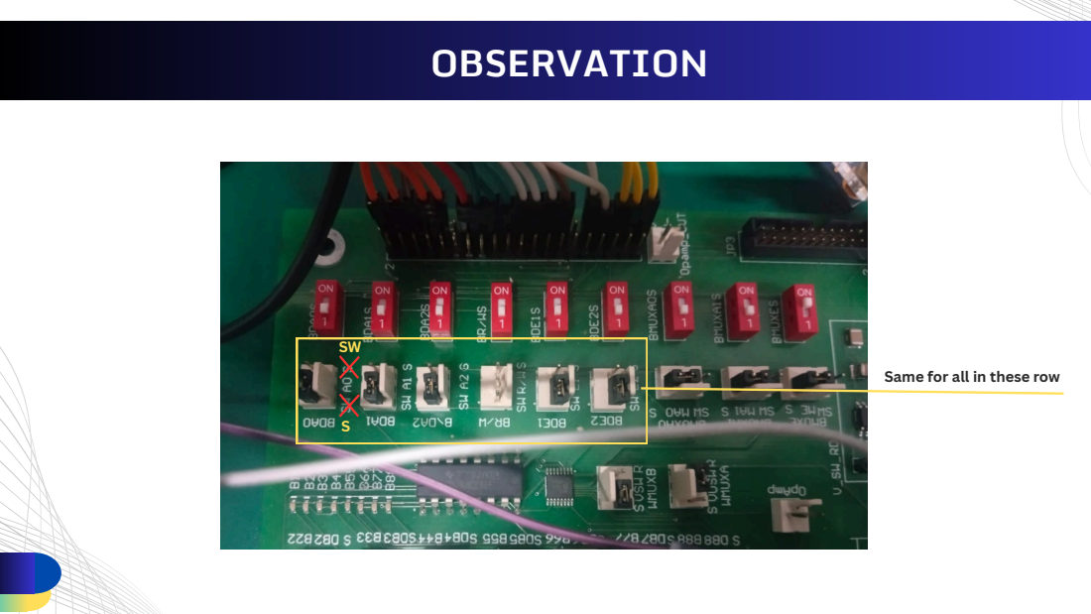
[picture p63: page 38]

# OBSERVATION

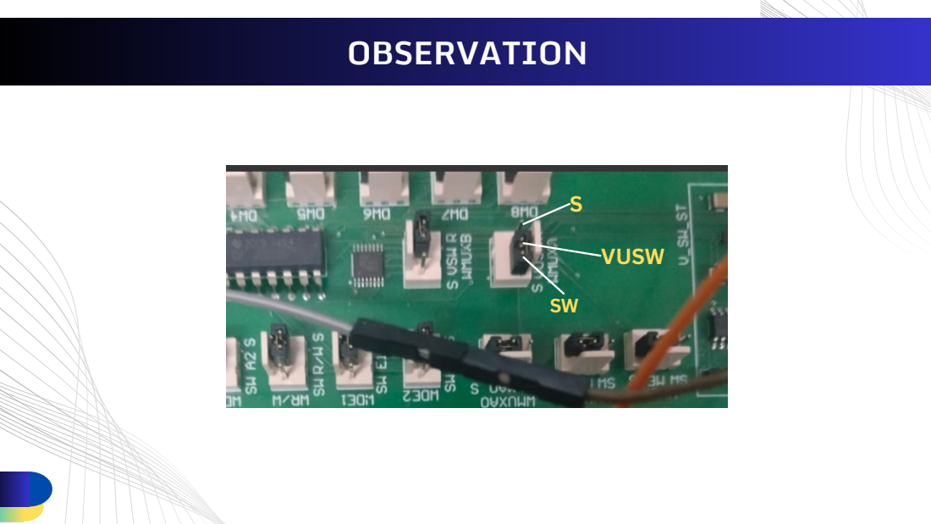
[picture p64: page 39]
VUSW

# OBSERVATION

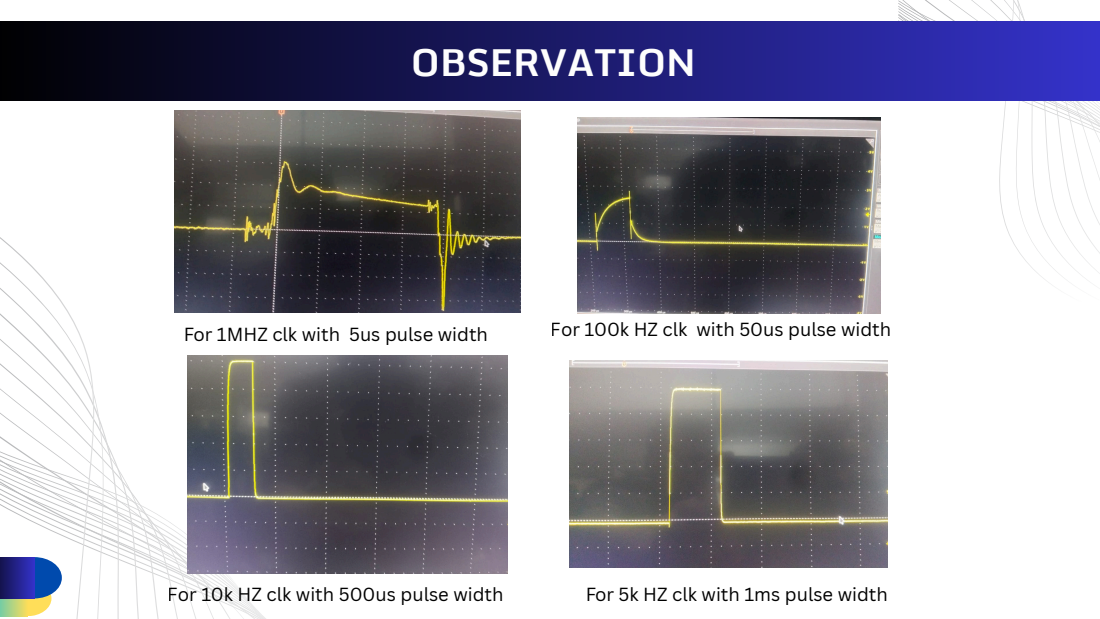
[picture p65: page 40]
For 1MHZ clk with 5us pulse width; For 100k HZ clk with 50us pulse width; For 10k HZ clk with 500us pulse width; For 5k HZ clk with 1ms pulse width

# OBSERVATION

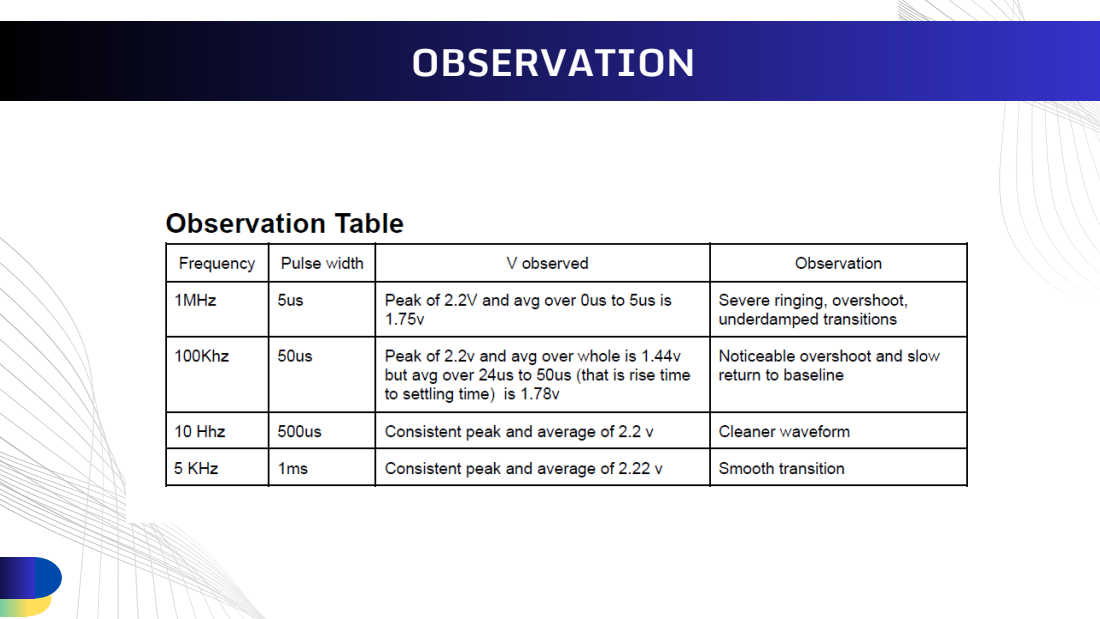
[picture p66: page 41]

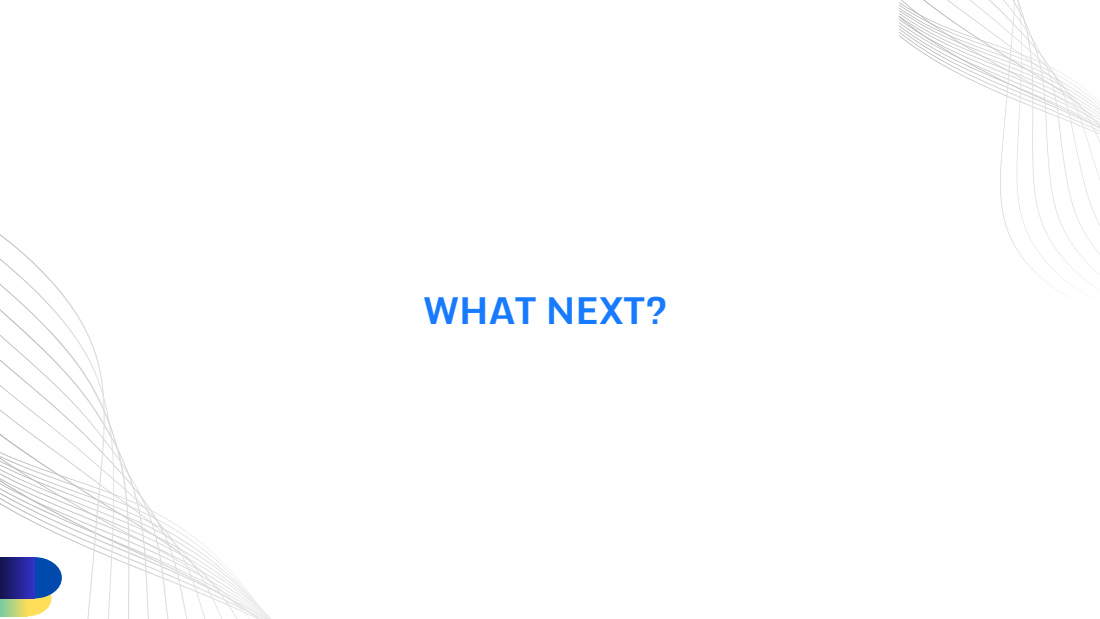
[picture p67: page 42]
WHAT NEXT?

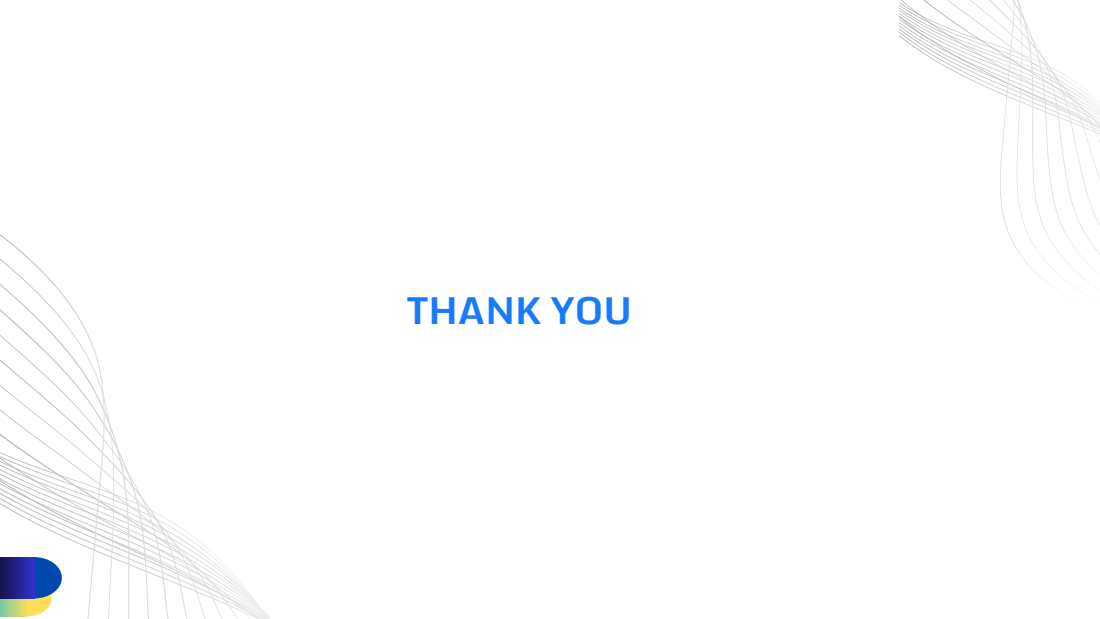
[picture p68: page 43]
THANK YOU

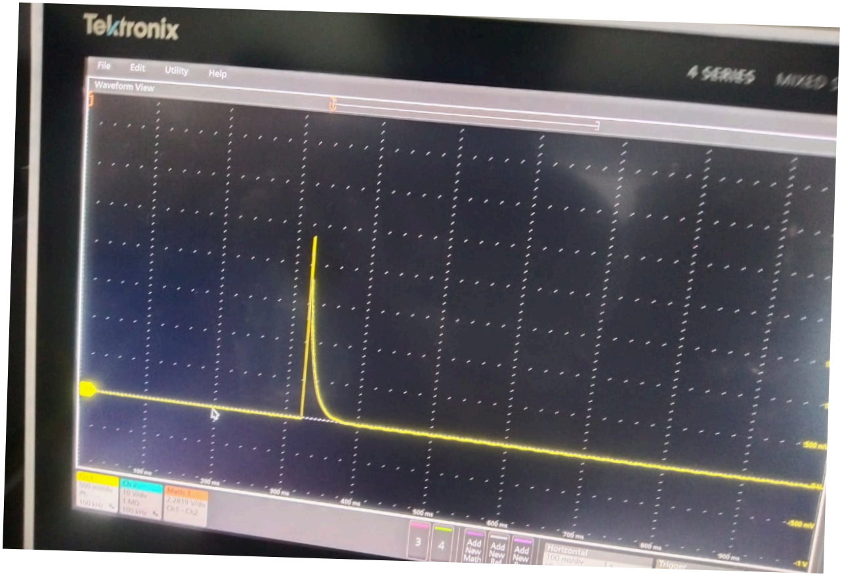
[picture p69: figure]

# For 50MHZ clk with 5ns pulse width

3:8

c

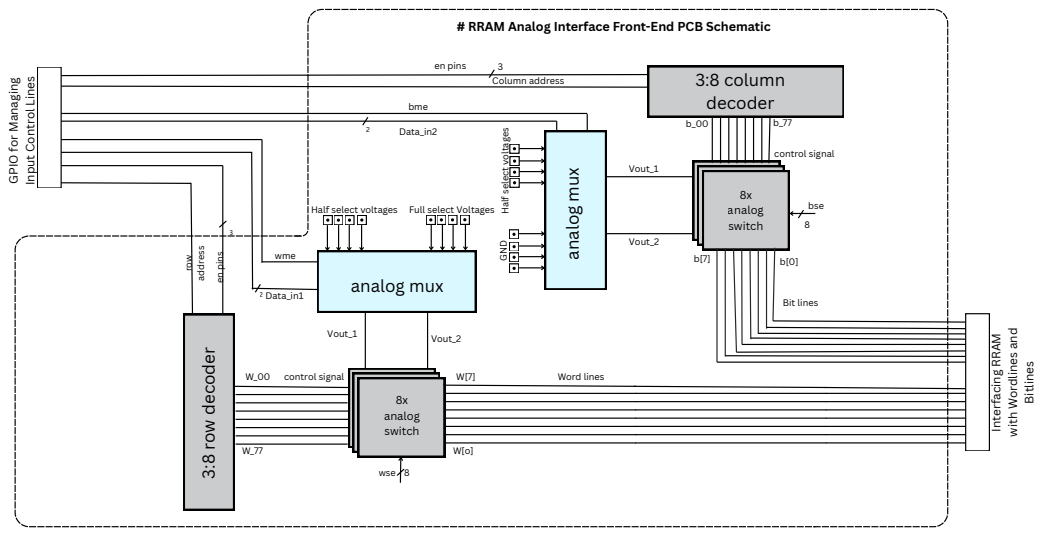
[picture p70: page 45]
3:8 row decoder; analog mux; pin; row; address; en pins; sig; Bit; lin; Interfacing RRAM; Bitlines

Input Control Lines

GPIO for Managing

Half select voltages GND

with Wordlines and

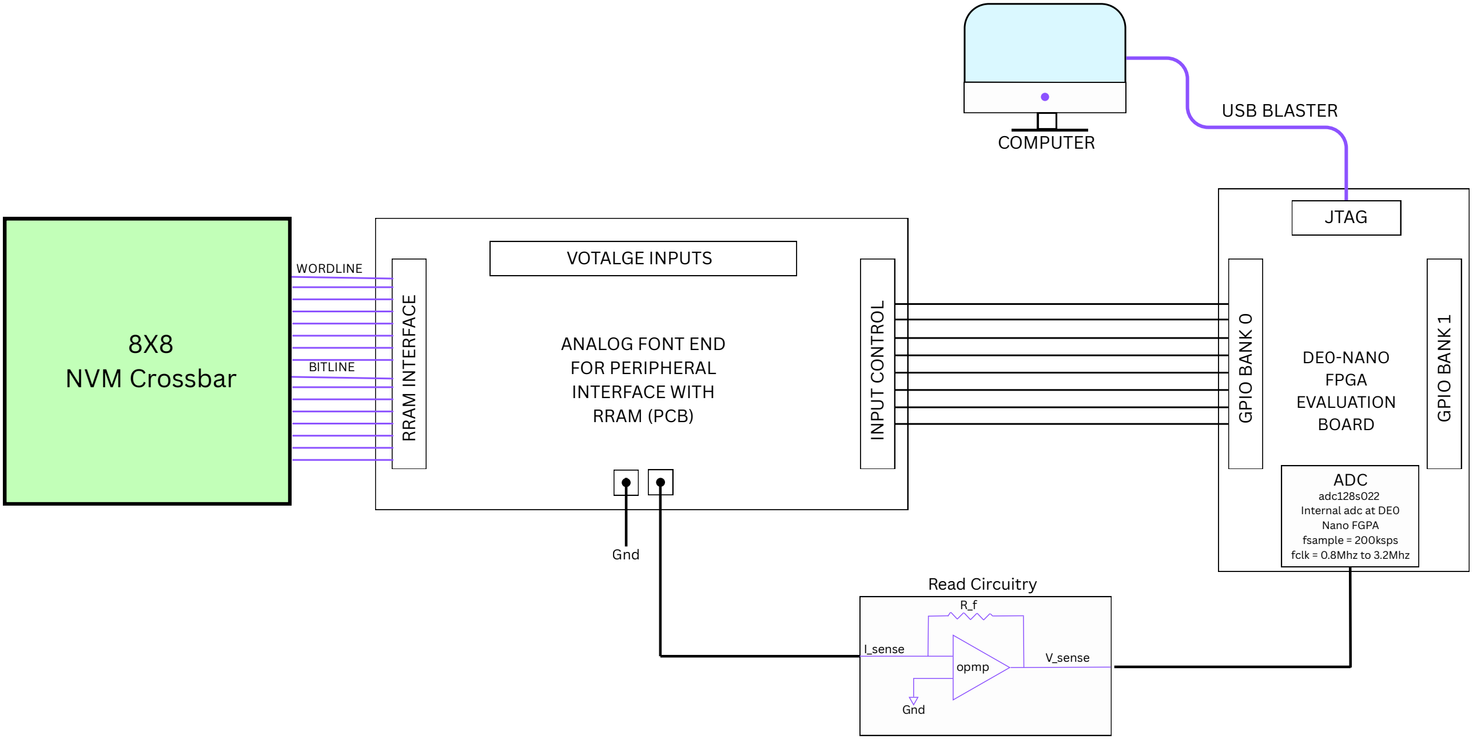
[picture p71: figure]
I_sense; V_sense; Gnd; opmp; Read Circuitry; ADC; adc128s022 Internal adc at DE0 Nano FGPA fsample = 200ksps fclk = 0.8Mhz to 3.2Mhz; DE0-NANO FPGA EVALUATION BOARD; RRAM INTERF; ACE; INPUT CONTROL; ANALOG FONT END FOR PERIPHERAL INTERFACE WITH RRAM (PCB); VOTALGE INPUTS; GPIO BANK 0; GPIO BANK 1; USB BLASTER; JTAG; COMPUTER; 8X8 NVM Crossbar; WORDLINE; BITLINE
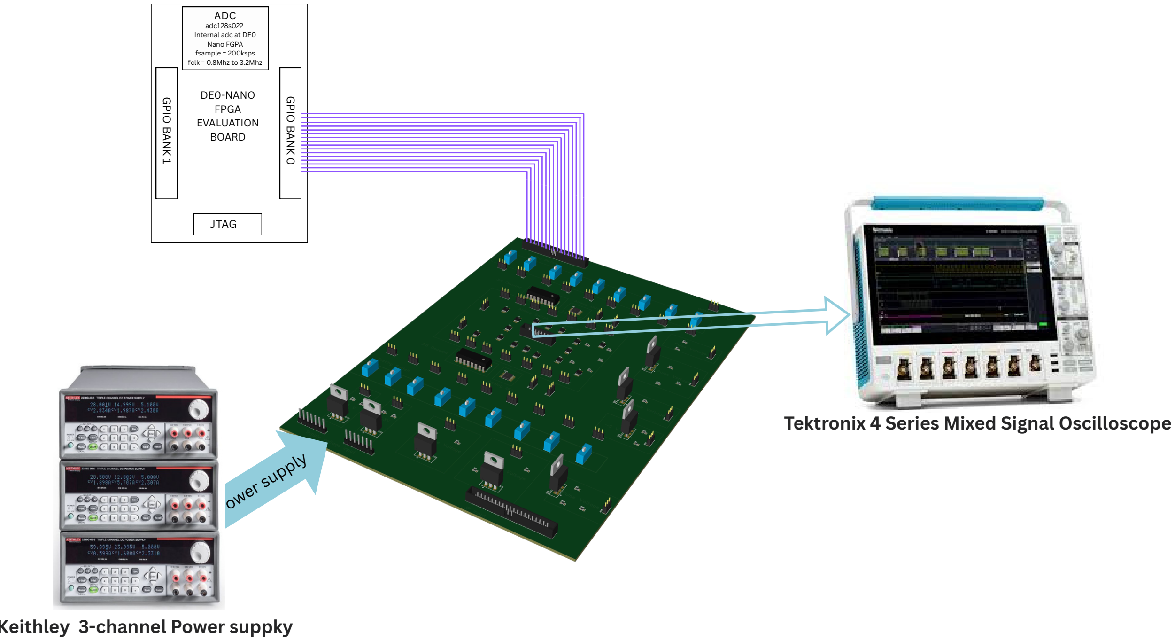
[picture p72: page 47]

# Power supply

ADC
adc128s022
Internal adc at DE0
Nano FGPA
fsample = 200ksps
fclk = 0.8Mhz to 3.2Mhz

DE0-NANO
FPGA
EVALUATION
BOARD

GPIO BANK 1 GPIO BANK 0

JTAG

# Keithley 3-channel Power suppky

# Tektronix 4 Series Mixed Signal Oscilloscope
