USb-dB/5ns-Spike-Based-RRAM-Memory-Controller-/LT Spice Files/Readout_circuit.asc

Fast_recovery_diode: 1SS309
Peak_detecting_cap: cap; 100p
R_RRAM: res; 10k
R_sense: res; 10k
Read_pulse: voltage; PULSE(0 -1 100n 1n 1n 100n 1u 1)
Transimpledence_amplifier: LT1357
V1: voltage; 5
V2: voltage; -5
Named nets: 0, V_out, V_dd, V_ss, V_pulse
.tran 0 1 0
